jadonk/whitherbone/README.md

# whitherbone

Whithervanes: a neurotic, early worrying system are weathervanes controlled by the climate of fear on the Internet. They were first presented on five buildings in the seaside town of Folkestone, UK as part of the 2014 Folkestone Triennial. The Whithervanes parse newsfeeds looking for predetermined keywords related to fear (e.g. natural disaster, economic collapse, war, etc.) When fear is encountered the chickens respond by rotating away at increasing speeds from fear hot-spots and illuminating different colors triggered by specific levels of fear. Subsequently, 3 more full-size Whithervanes have been commissioned by Locust Projects in Miami for 2018.

We've been asked many times how people can have their own Whithervane. So, we are making the Whithervanes Open Hardware Kit. A prototype version was included in the “Are you talking to me?” exhibition currently in St. Etienne, France. We want to make the Whithervanes Open Hardware Kit a PocketBeagle derivative (Whitherbone), and need some help to do this.

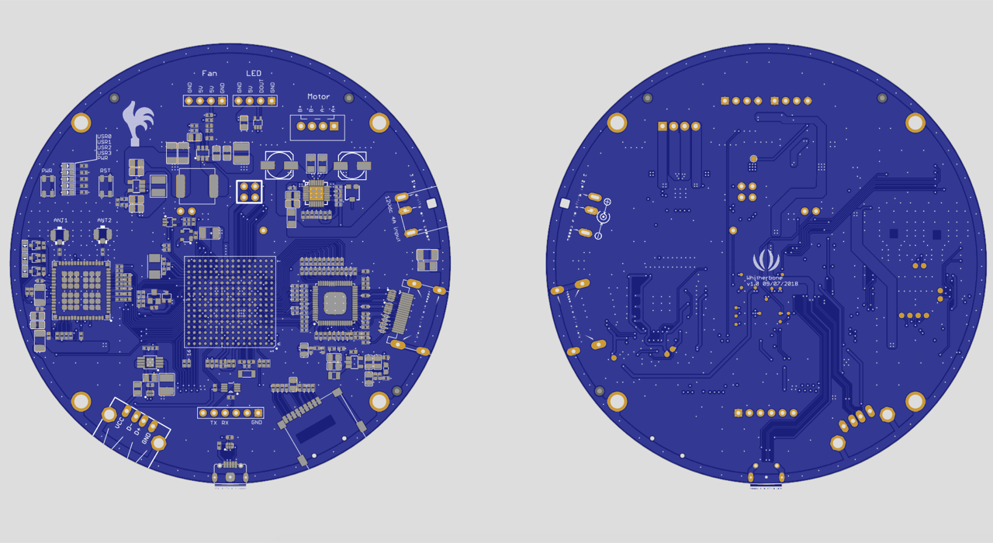
[picture p1: whitherbone.png]
whitherbone rendering Whitherbone


http://www.whithervanes.com/

## Fan
| Pin | Signal |
| --- | --- |
| 1 | GND |
| 2 | +5V |
| 3 | +5V |
| 4 | GND |

## Neopixel ring (LED)

| Pin | Signal | CPU ball | PRU  | SPI | GPIO | 
| --- | --- | --- | ---- | --- | ---- |
| 1 | GND | | | | | 
| 2 | Data (DOUT)  | B2 | 0.2  | 1-MOSI | 112  | 
| 3 | +5V | | | | | 
| 4 | GND | | | | | 

## Motor

### Connector

| Pin | Signal | Wires  |
| --- | --- | --- |
| 1 | Coil 1+ (A+) | Red |
| 2 | Coil 1- (A-) | Green  |
| 3 | Coil 2- (B-) | Blue |
| 4 | Coil 2+ (B+) | Yellow | 

### Control signals

| Ball | GPIO | Signal |
| ---- | ---- | --- |
| T4 | 22 | Step |
| P5 | 23 | Direction |
| R5 | 26 | Reset |
| T5 | 27 | uS1 |
| P6 | 44 | uS2 |
| R6 | 45 | uS3 |
| T6 | 46 | Enable |
| P7 | 47 | Sleep
