jadonk/whitherbone/EAGLE/early-placement.png

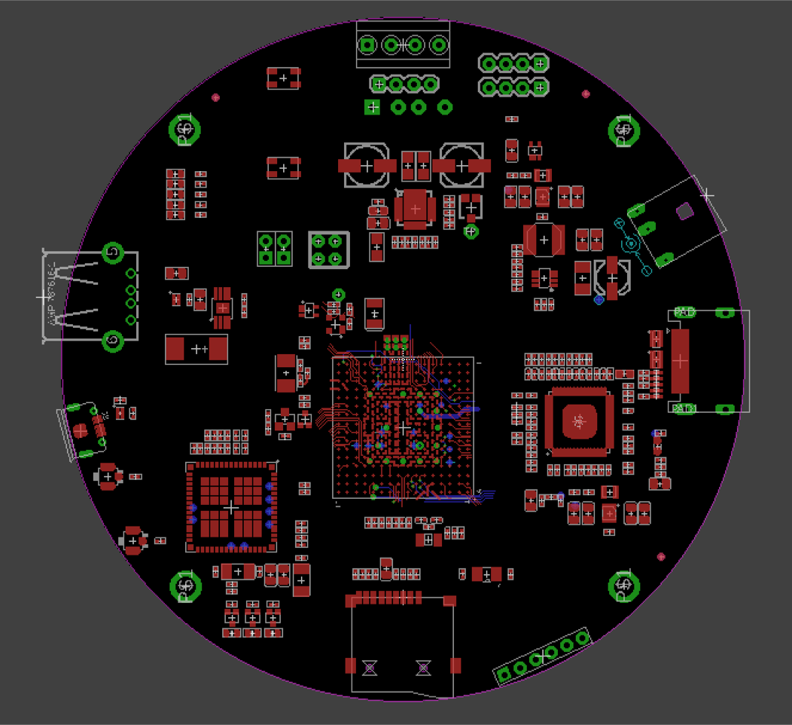
EAGLE/early-placement.png
