jadonk/whitherbone/whitherbone.dxf

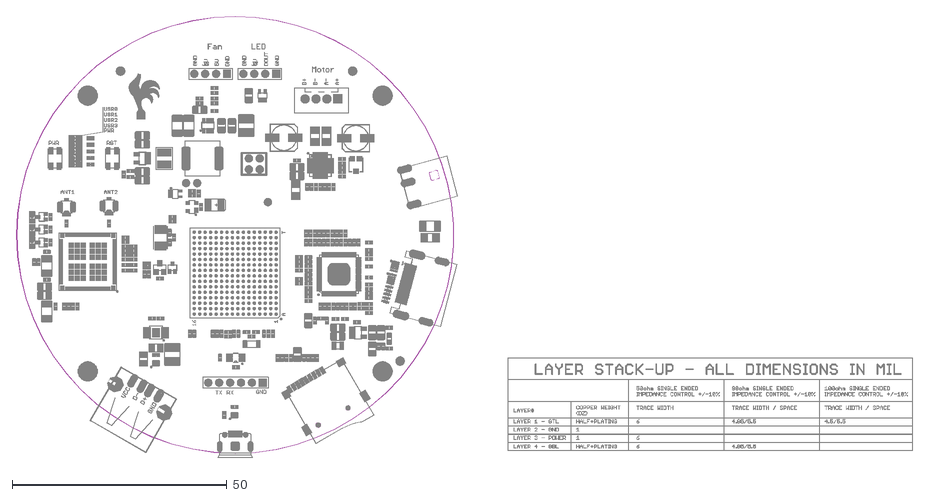
[picture p3: CAD file, 2018-09-12]
whitherbone.dxf
208.4 x 102.7
