jadonk/whitherbone/(threads)

Thread 1 (2017-12-11):

Add TFP410 for HDMI (DVI-D) output

jadonk, 2017-12-11:
TFP410 is desirable due to long product life from TI. Had some issues with the TDAx devices going EOL.

* No audio required, so TFP410 is sufficient. This makes it "DVI-D" to avoid HDMI brand issues, but uses the connector for reduced size and increased cable compatibility.
* Use full-sized HDMI connector.
* Example TFP410 usage at https://github.com/beagleboard/beagleboard-xm/blob/master/BeagleBoard-xM_SCH.pdf, but need to switch to 3.3V signals, not 1.8V.
* BeagleBone HDMI hook-up example at https://github.com/beagleboard/beaglebone-black/blob/master/BBB_SCH.pdf.
* Data lines already connected to avoid potential doubts.
* PocketBeagle use of analog inputs on a couple of the LCD signal lines can be ignored in the case compatibility with expansion boards is desired as an option, but they can also be removed as expansion board compatibility is at most a nice-to-have.

jadonk, 2018-07-16:
I ended up copying the HDMI from BeagleBone Black Wireless, but using the full-sized HDMI connector. I chose a connector I could find easily, though I don't like the tab on it.

Closed 2018-07-16.

Thread 2 (2017-12-11):

Add stepper motor driver and 12V-to-5V based on "Big Easy Driver"

jadonk, 2017-12-11:
Use these links for reference and be sure to provide proper attribution:
* http://www.schmalzhaus.com/BigEasyDriver/index.html
* https://cdn.sparkfun.com/datasheets/Robotics/EasyDriver_v45.pdf

Main devices used:
* LM317: power consumption not a big concern, so keep it simple.
* A3967SLB: lots of other drivers available, but this one is known to work in the application.

I'll probably just grab the KiCAD parts from SnapEDA.

jadonk, 2018-07-17:
EasyDriver and BigEasyDriver aren't the same things. I tried to just cut-and-paste the BigEasyDriver and connect it to GPIOs.

Instead of using an LM317, I added a 7805.

Closed 2018-07-17.

Thread 3 (2017-12-11):

Add WiFi/BT using WL1835MOD based on BeagleBone Blue

jadonk, 2017-12-11:
Need both WiFi and BT. 2.4GHz is sufficient. Simplest just to replicate a known-good interface.

See https://github.com/beagleboard/beaglebone-blue/blob/master/BeagleBone_Blue_sch.pdf for reference.

RobertCNelson, 2017-12-12:
How about the WL1837? So we can get the 5Ghz band??? ;)

RobertCNelson, 2017-12-12:
Bluetooth audio? Remember we need those pull-up's, otherwise remember what happened on teh Green Wireless..

RobertCNelson, 2017-12-12:
n/m it's +$7 / 1ku premium over wl1835modl

jadonk, 2017-12-14:
Yeah, the price is the issue. Maybe it doesn't matter so much and we'll use
that one instead. Probably availability is the biggest deciding factor.
Footprint is compatible.

On Mon, Dec 11, 2017 at 9:54 PM Robert Nelson <notifications@github.com>
wrote:

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
--
https://beagleboard.org/about

jadonk, 2018-07-18:
Which pull-ups?

Got it added based on Black Wireless, then removed the level shifters.

Closed 2018-07-18.

Thread 4 (2017-12-11):

Add 12V power input

jadonk, 2017-12-11:
Use a standard barrel jack.

Feed to LM317 which should provide power to both the stepper motor driver and the "DC" input on the SIP PMIC.

jadonk, 2018-07-17:
Added 7805.

Closed 2018-07-17.

Thread 5 (2017-12-11):

Add fan connector

jadonk, 2017-12-11:
Using this fan: https://www.digikey.com/products/en?keywords=259-1575-nd

Need to determine if a GPIO control is needed or if it is just continuous run. I believe it is just continuous.

jadonk, 2018-07-18:
I just threw on a 4-pin and made outer GND and inner 5V. I also threw on a cap.

Closed 2018-07-18.

Thread 6 (2017-12-11):

Add connector for Neopixel ring

jadonk, 2017-12-11:
Here's the Neopixel ring: https://www.adafruit.com/product/1586

Needs 5V, GND and signal.

Signal thoughts:
* Use a PRU-capable-GPIO for the signal
* Assuming sk6812 controller
* Some consideration of the LEDscape library: https://libraries.io/github/Yona-Appletree/LEDscape
* A SPI-MOSI connection might also be of some benefit if programming was done that way, instead of using PRUs
* I'm thinking BSM ball B2 (ZCZ ball D12) which is SPI1_D1 (mode 3), PRU0_OUT2 (mode 5) and GPIO3_16

Needs some input on planned programming model

jadonk, 2018-07-18:
Stuck a 4 pin connector on there for now. Added on a 74AHCT125 for level shifting, but it is a bit of overkill (4 output).

Closed 2018-07-18.

Thread 10 (2018-07-19):

Review from Erik Welsh

jadonk, 2018-07-19:
1) Connect VIN_BAT to PMIC_BAT_SENSE, per recommendation in TPS65217 datasheet rev I figure 56.

2) From BBBW, add one or two cap footprints on both the input and output of the flip flop (IC13) to allow for easy addition of filtering caps when testing for FCC/CE.  Alternatively, you could you could add an external 12MHz oscillator (ASDMB-12.000MHZ-LC-T) and use the same clock disable.

3) On the BigEasy Driver, the VDD needs to be 3.3V and not 5V so that the IO voltage is 3.3V.

4) The datasheet for the A4983 recommends bulk capacitors on the VBB.  Currently there is a 47uF on the 12V input.  Depending on where that is placed, it might be enough, but you should check once you have more placement done to see if you need to put an additional bulk cap on VBB.

5) Would suggest using something like the Tag Connect footprint for the JTAG connector.

6) Not sure if you want to add all the testpoints for the WL1835 (see BB Blue)

7) Depending on the layout, you can flip the D+ / D- inputs of IC14 and IC15.  Within the TPD4S012, D+ and D- are the same circuit.

8) You might want to look at a different package (i.e. the DQA vs the DGS) for IP4283CZ10 (TPD4S009DGSR).

9) You might want to look at the SOT-223 package for the 7805T  depending on cost vs board area needs.

Thread 11 (2018-08-02):

Organize the hardware design requirements

qunanan, 2018-08-02:
**Schematic**

1. 12V power input. Since the 7805 is low efficiency, let's use DCDC modulator insted.
2. Based on OSD3358-SM-RED with eagle project.
3. WiFi&Bluetooth enableing with WL1835 module
4. TFP410 for HDMI output, full size HDMI connector
5. Stepper motor controller based on "Big Easy Driver"
6. Screw terminal connector for Motor, it is stable and in common use
7. Voltagle level shiffting for Neopixel ring. Make a 4pin connector for it.Pay atention with the control pin.
8. A continuous running fan is needed.
9. Status LEDs should be included.
10. Reset and power buttons should be included.
11. There should be a serial header.

**PCB Layout**

1. Make board circular at standard thickness(1.6mm)
2. Diameter must be less than 4" and is desired to be as small as possible
3. Edge connectors should be placed on edges with any particular restriction except to simplify layout
4. Try to stick to a 4 layer board for easy OSHPark production

qunanan, 2018-08-02:
Maybe we can use IT66121FN for HDMI interface.It's much lower cost.
See HDMI cape for BBG: [https://www.seeedstudio.com/SeeedStudio-BeagleBone-Green-HDMI-Cape-p-2570.html](url)

Thread 12 (2018-09-13):

Layout Review Feedback

erikwelsh, 2018-09-13:
Found a couple of things while reviewing the layout:

1) The PWR_IN_12V doesn't look connected to power connector very well.  There is plenty of room on the top to make that connection better

2) There is some weird keepout around the PWR_IN_12V via on the Route15 layer which is causing connection issues.  It looks like the footprint for that connector is not correct

3) The SYS_VDD1_3P3V pour on the Route15 layer is not straight on the right side

4) There is a weird little stub pour on the Route15 layer for N$14

5) Are the two antennas far enough apart?  I wasn't sure the min distance for MIMO.

qunanan, 2018-09-14:
Hi,
1. The layout file is not the latest. It has been Fixed.
2. This is a known issue caused by the earlier version of Eagle, it's not good support for the slot pad. The gerber file is correct.
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
3. Sorry, I don't really understand what do you mean, can you explain more detailedly
4. Fixed
5.No, but I think we could the put the antennas far apart since there is wire between the antennas an d connectors.

Thread 13 (2018-09-13):

Schematic printing issue

erikwelsh, 2018-09-13:
There is some text on the "guide" layer (98) which is causing printing issues.  You can either move or delete the text.

Closed 2018-11-13.

Thread 14 (2018-11-13):

Need to create device tree

jadonk, 2018-11-13:
Seeed did most of this hack. I just added the WIFI LED.

This needs to be cleaned up.

```
From 6b8c1664318fc4ec7c0b2a9de9507e0a6be16978 Mon Sep 17 00:00:00 2001
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
