jadonk/whitherbone/EAGLE/whitherbone_sch.pdf

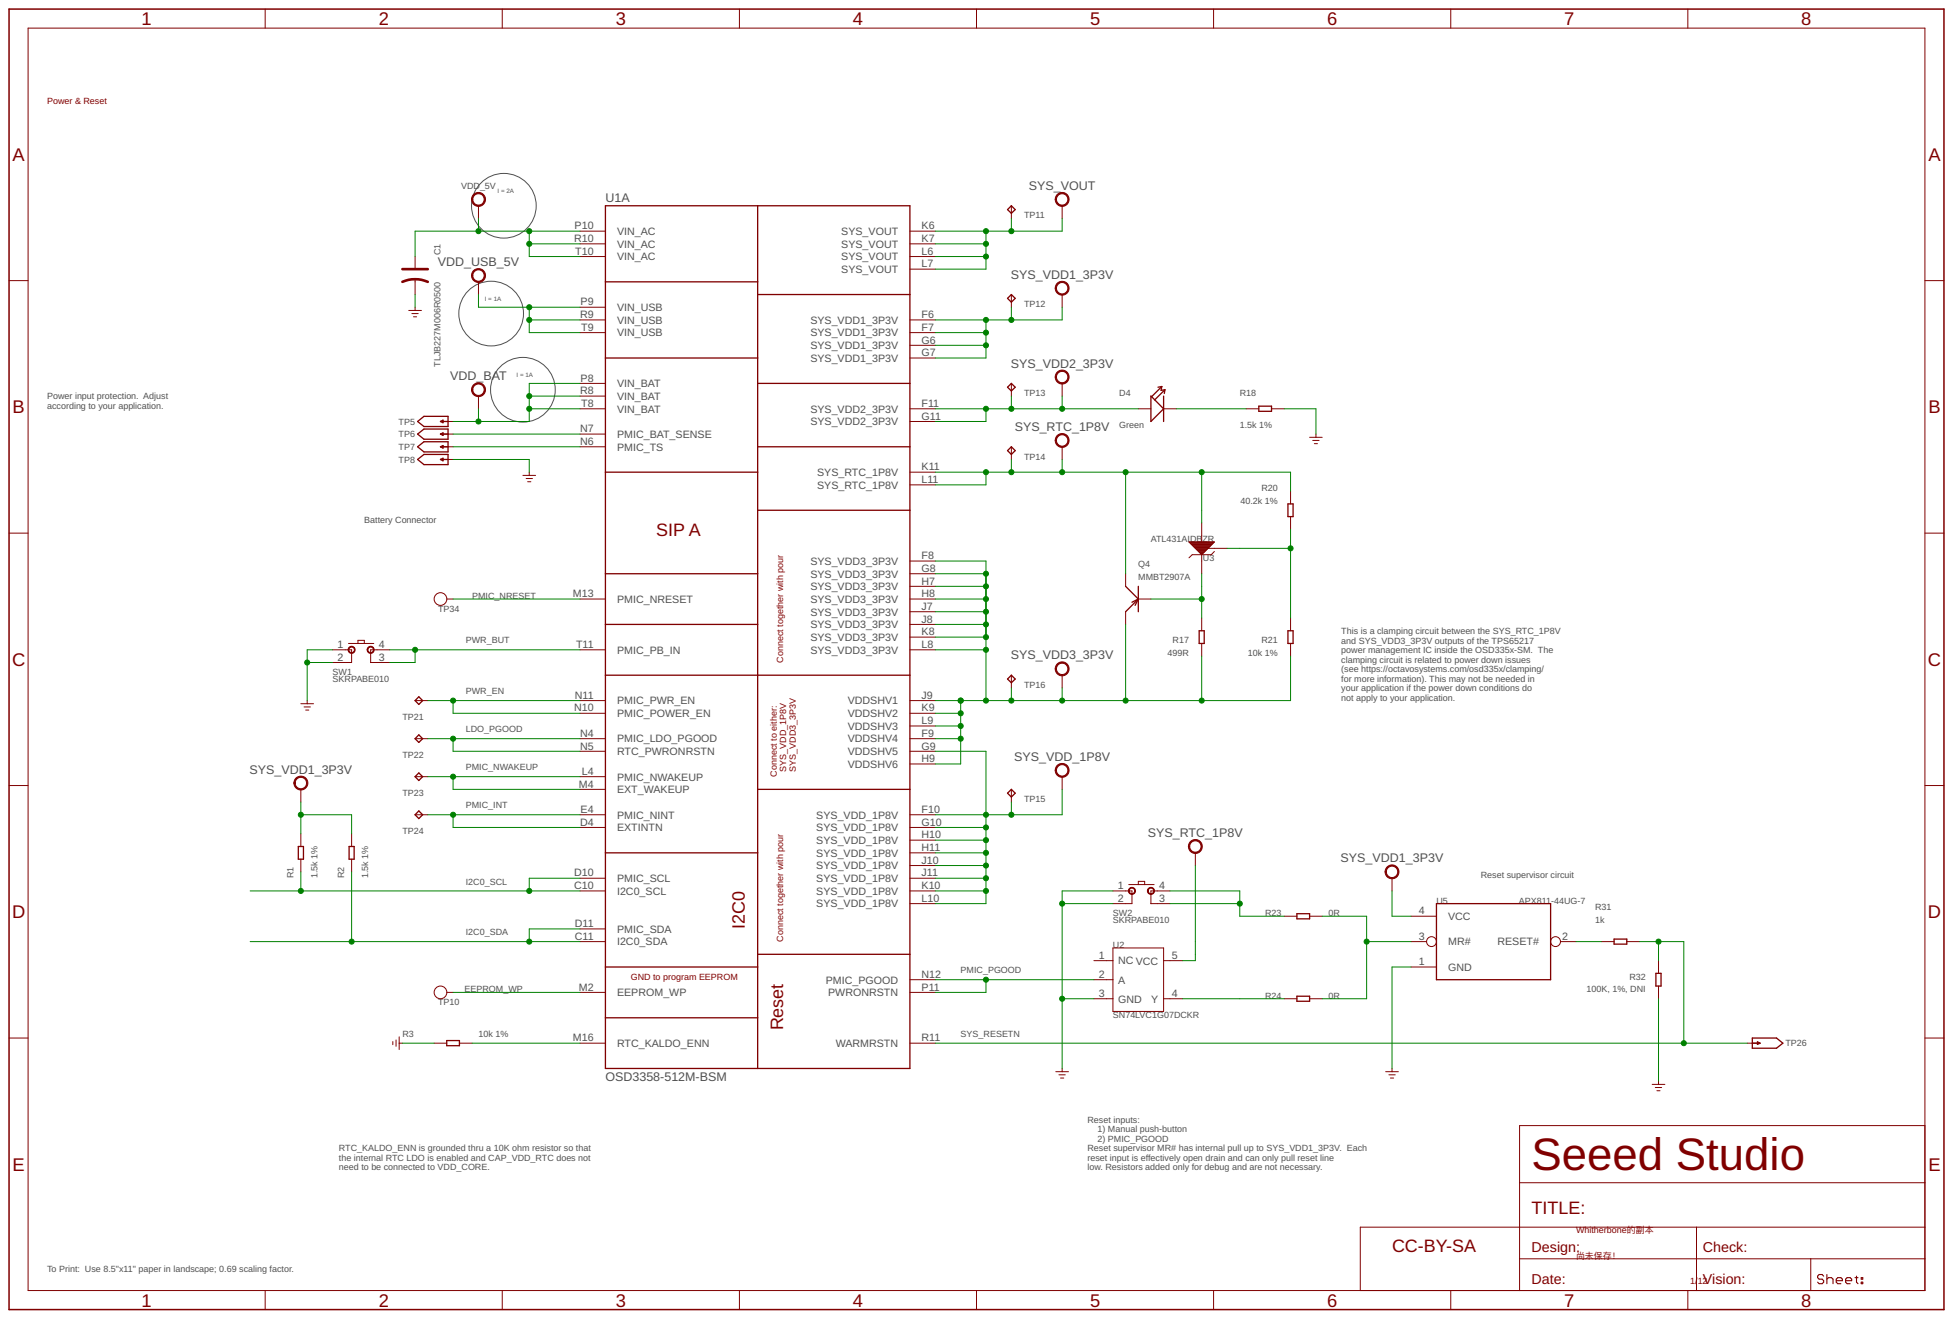
[picture p4: page 1]

Power input protection. Adjust according to your application.

SYS_VDD3_3P3V Connect together with pour Connect together with pour

This is a clamping circuit between the SYS_RTC_1P8V
and SYS_VDD3_3P3V outputs of the TPS65217
power management IC inside the OSD335x-SM. The
clamping circuit is related to power down issues
(see https://octavosystems.com/osd335x/clamping/
for more information). This may not be needed in
your application if the power down conditions do
not apply to your application.

et Connect to either: SYS_VDD_1P8V

GND to program EEPROM

Reset inputs: 1) Manual push-button
2) PMIC_PGOOD
Reset supervisor MR# has internal pull up to SYS_VDD1_3P3V. Each
reset input is effectively open drain and can only pull reset line
low. Resistors added only for debug and are not necessary.

RTC_KALDO_ENN is grounded thru a 10K ohm resistor so that
the internal RTC LDO is enabled and CAP_VDD_RTC does not need to be connected to VDD_CORE.

CC-BY-SA | Whitherbone的副本 Design: 尚未保存！ | Check:

To Print: Use 8.5"x11" paper in landscape; 0.69 scaling factor.

Date: | Vision:

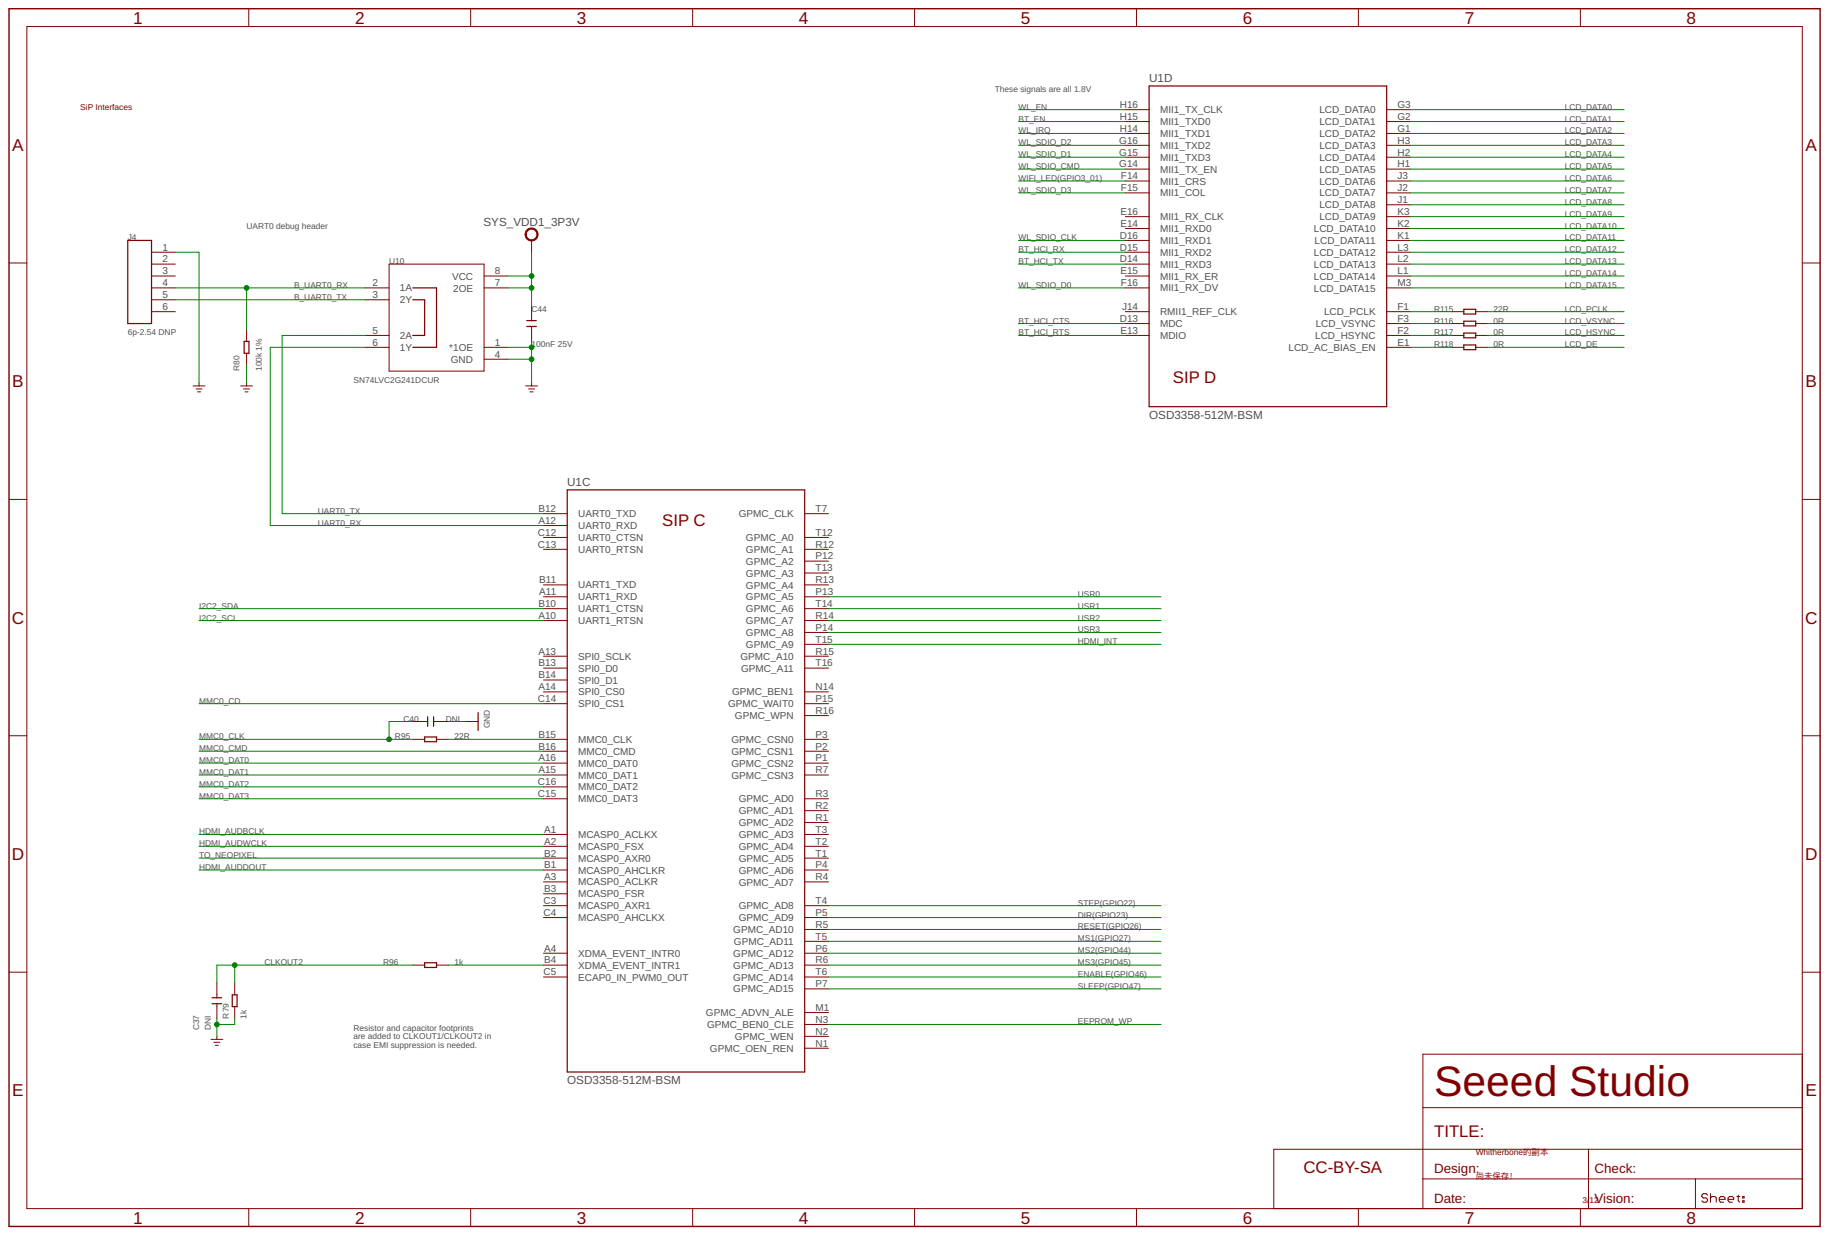
[picture p5: page 2]

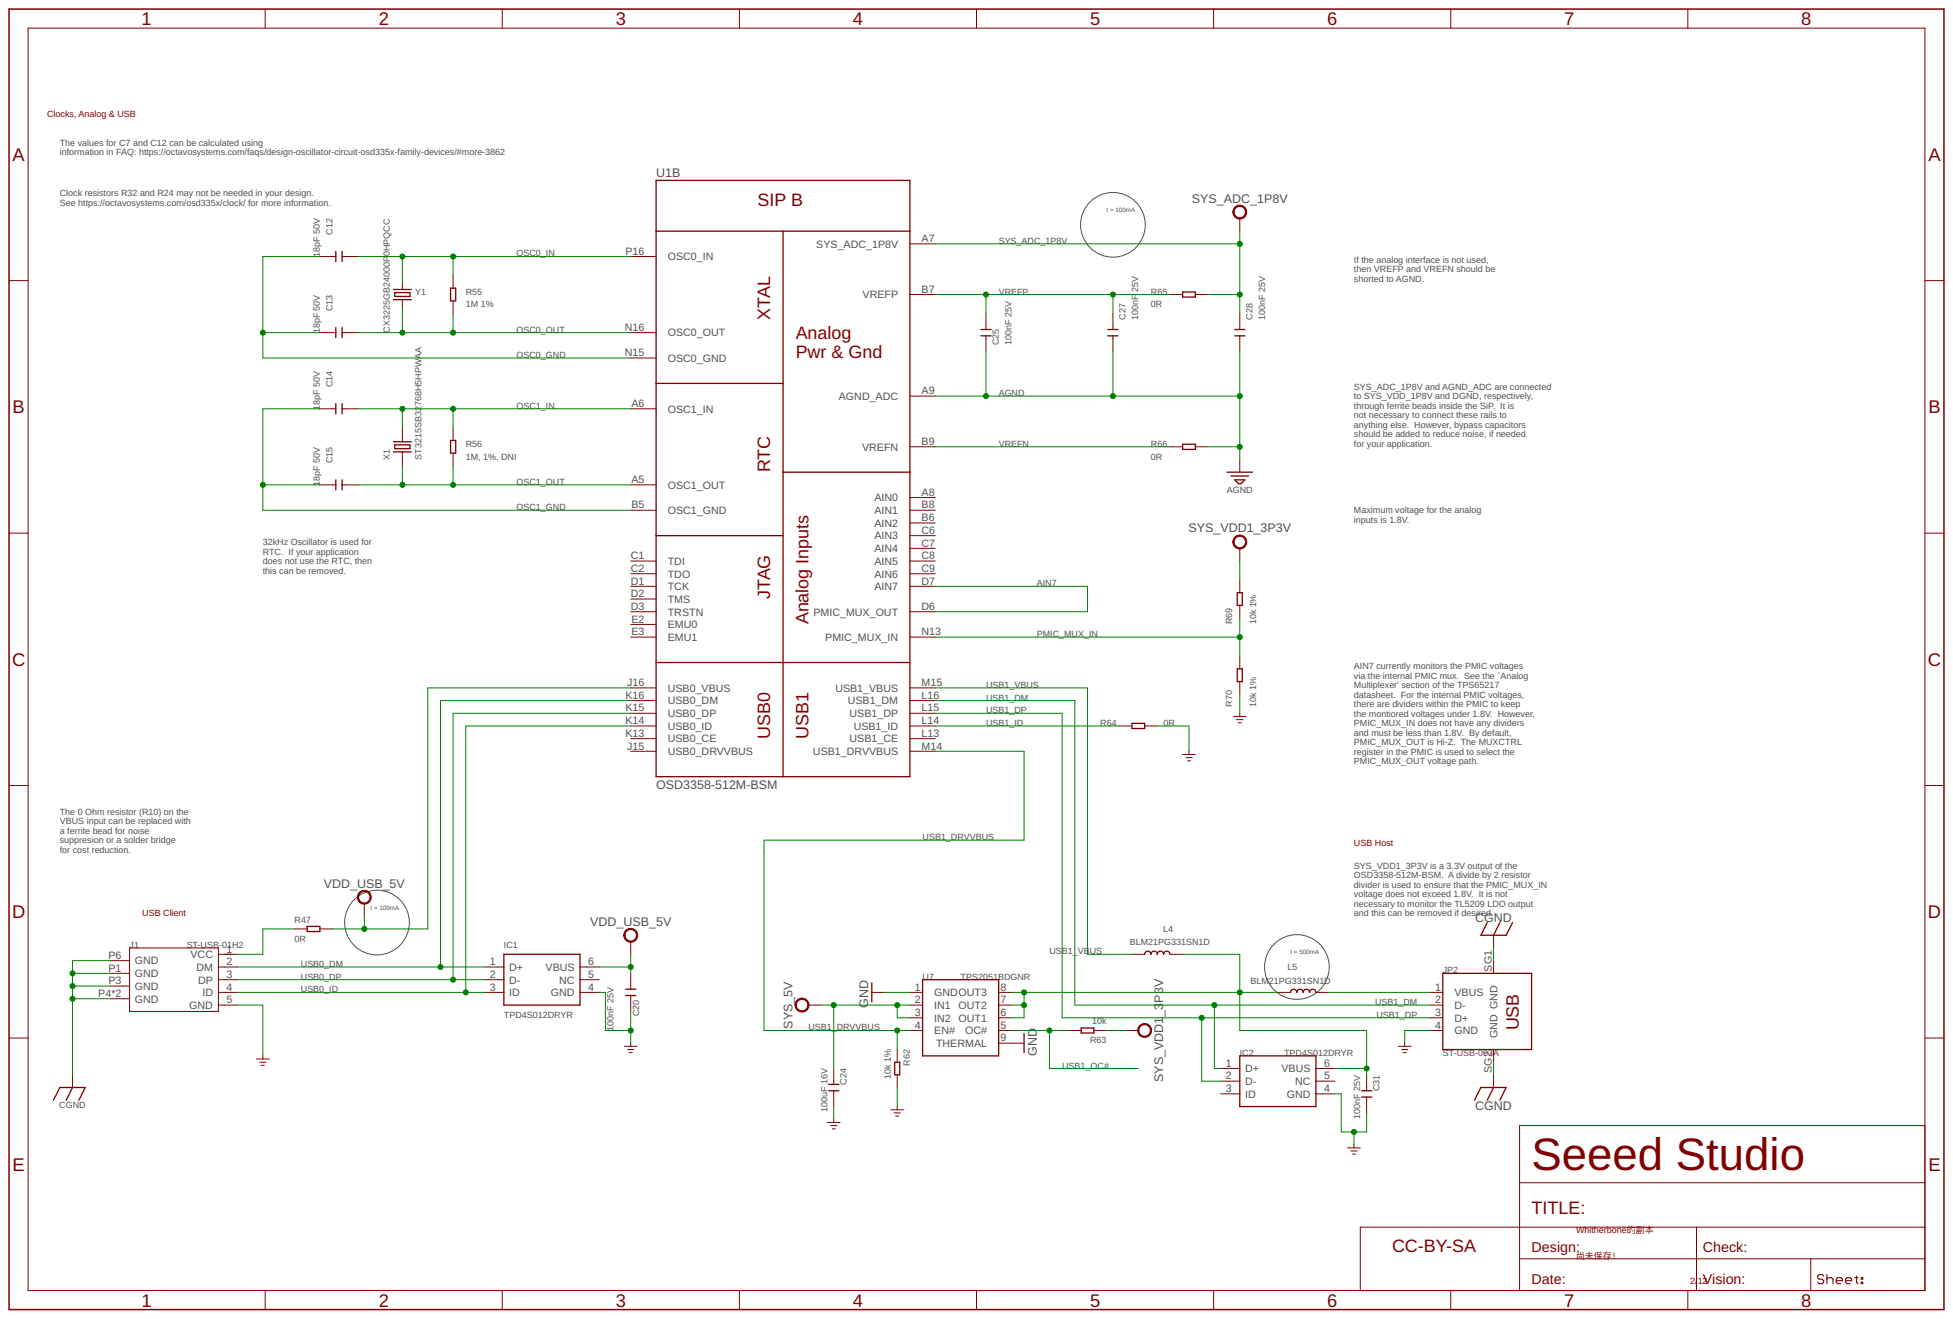
[picture p6: page 3]

The values for C7 and C12 can be calculated using
information in FAQ: https://octavosystems.com/faqs/design-oscillator-circuit-osd335x-family-devices/#more-3862

Clock resistors R32 and R24 may not be needed in your design. See https://octavosystems.com/osd335x/clock/ for more information.

OSC0_IN OSC0_OUT N16 OSC0_GND | SYS_ADC_1P8V VREFP Analog Pwr & Gnd AGND_ADC

If the analog interface is not used,
then VREFP and VREFN should be
shorted to AGND.

SYS_ADC_1P8V and AGND_ADC are connected
to SYS_VDD_1P8V and DGND, respectively,
through ferrite beads inside the SiP. It is not necessary to connect these rails to
anything else. However, bypass capacitors
should be added to reduce noise, if needed
for your application.

Maximum voltage for the analog
inputs is 1.8V.

32kHz Oscillator is used for RTC. If your application
does not use the RTC, then
this can be removed.

AIN7 currently monitors the PMIC voltages
via the internal PMIC mux. See the `Analog Multiplexer' section of the TPS65217
datasheet. For the internal PMIC voltages,
there are dividers within the PMIC to keep
the montiored voltages under 1.8V. However, PMIC_MUX_IN does not have any dividers and must be less than 1.8V. By default, PMIC_MUX_OUT is Hi-Z. The MUXCTRL

register in the PMIC is used to select the PMIC_MUX_OUT voltage path.

The 0 Ohm resistor (R10) on the VBUS input can be replaced with
a ferrite bead for noise
suppresion or a solder bridge
for cost reduction.

SYS_VDD1_3P3V is a 3.3V output of the OSD3358-512M-BSM. A divide by 2 resistor divider is used to ensure that the PMIC_MUX_IN

voltage does not exceed 1.8V. It is not necessary to monitor the TL5209 LDO output and this can be removed if desired.

3 USB1_DP

CC-BY-SA | Whitherbone的副本 Design: 尚未保存！ | Check:

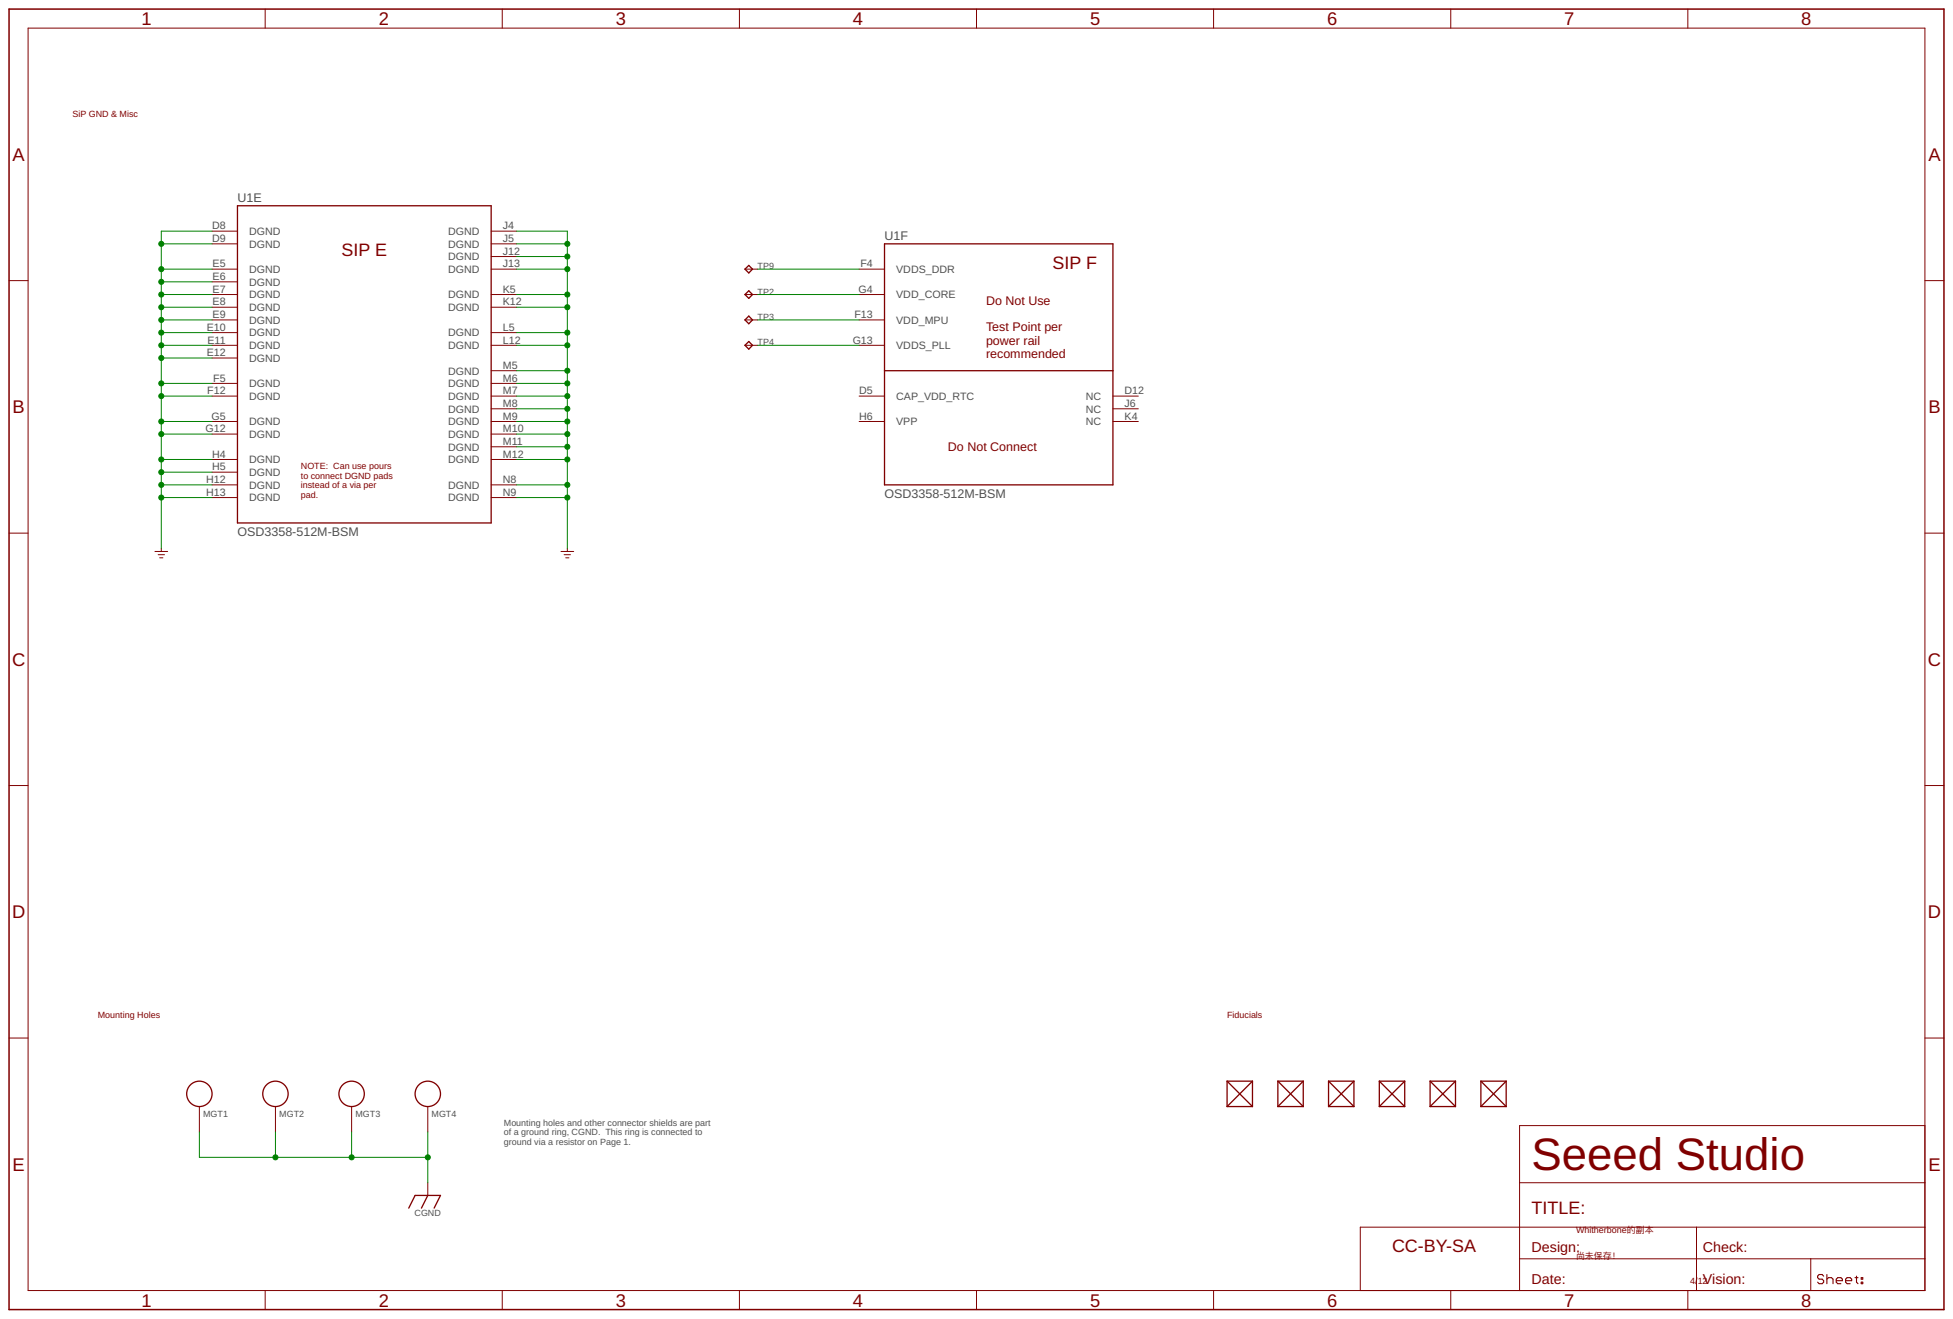
[picture p7: page 4]

Do Not Use Test Point per power rail recommended

NOTE: Can use pours
to connect DGND pads
instead of a via per pad.

Mounting holes and other connector shields are part of a ground ring, CGND. This ring is connected to
ground via a resistor on Page 1.

CC-BY-SA | Whitherbone的副本 Design: 尚未保存！ | Check:

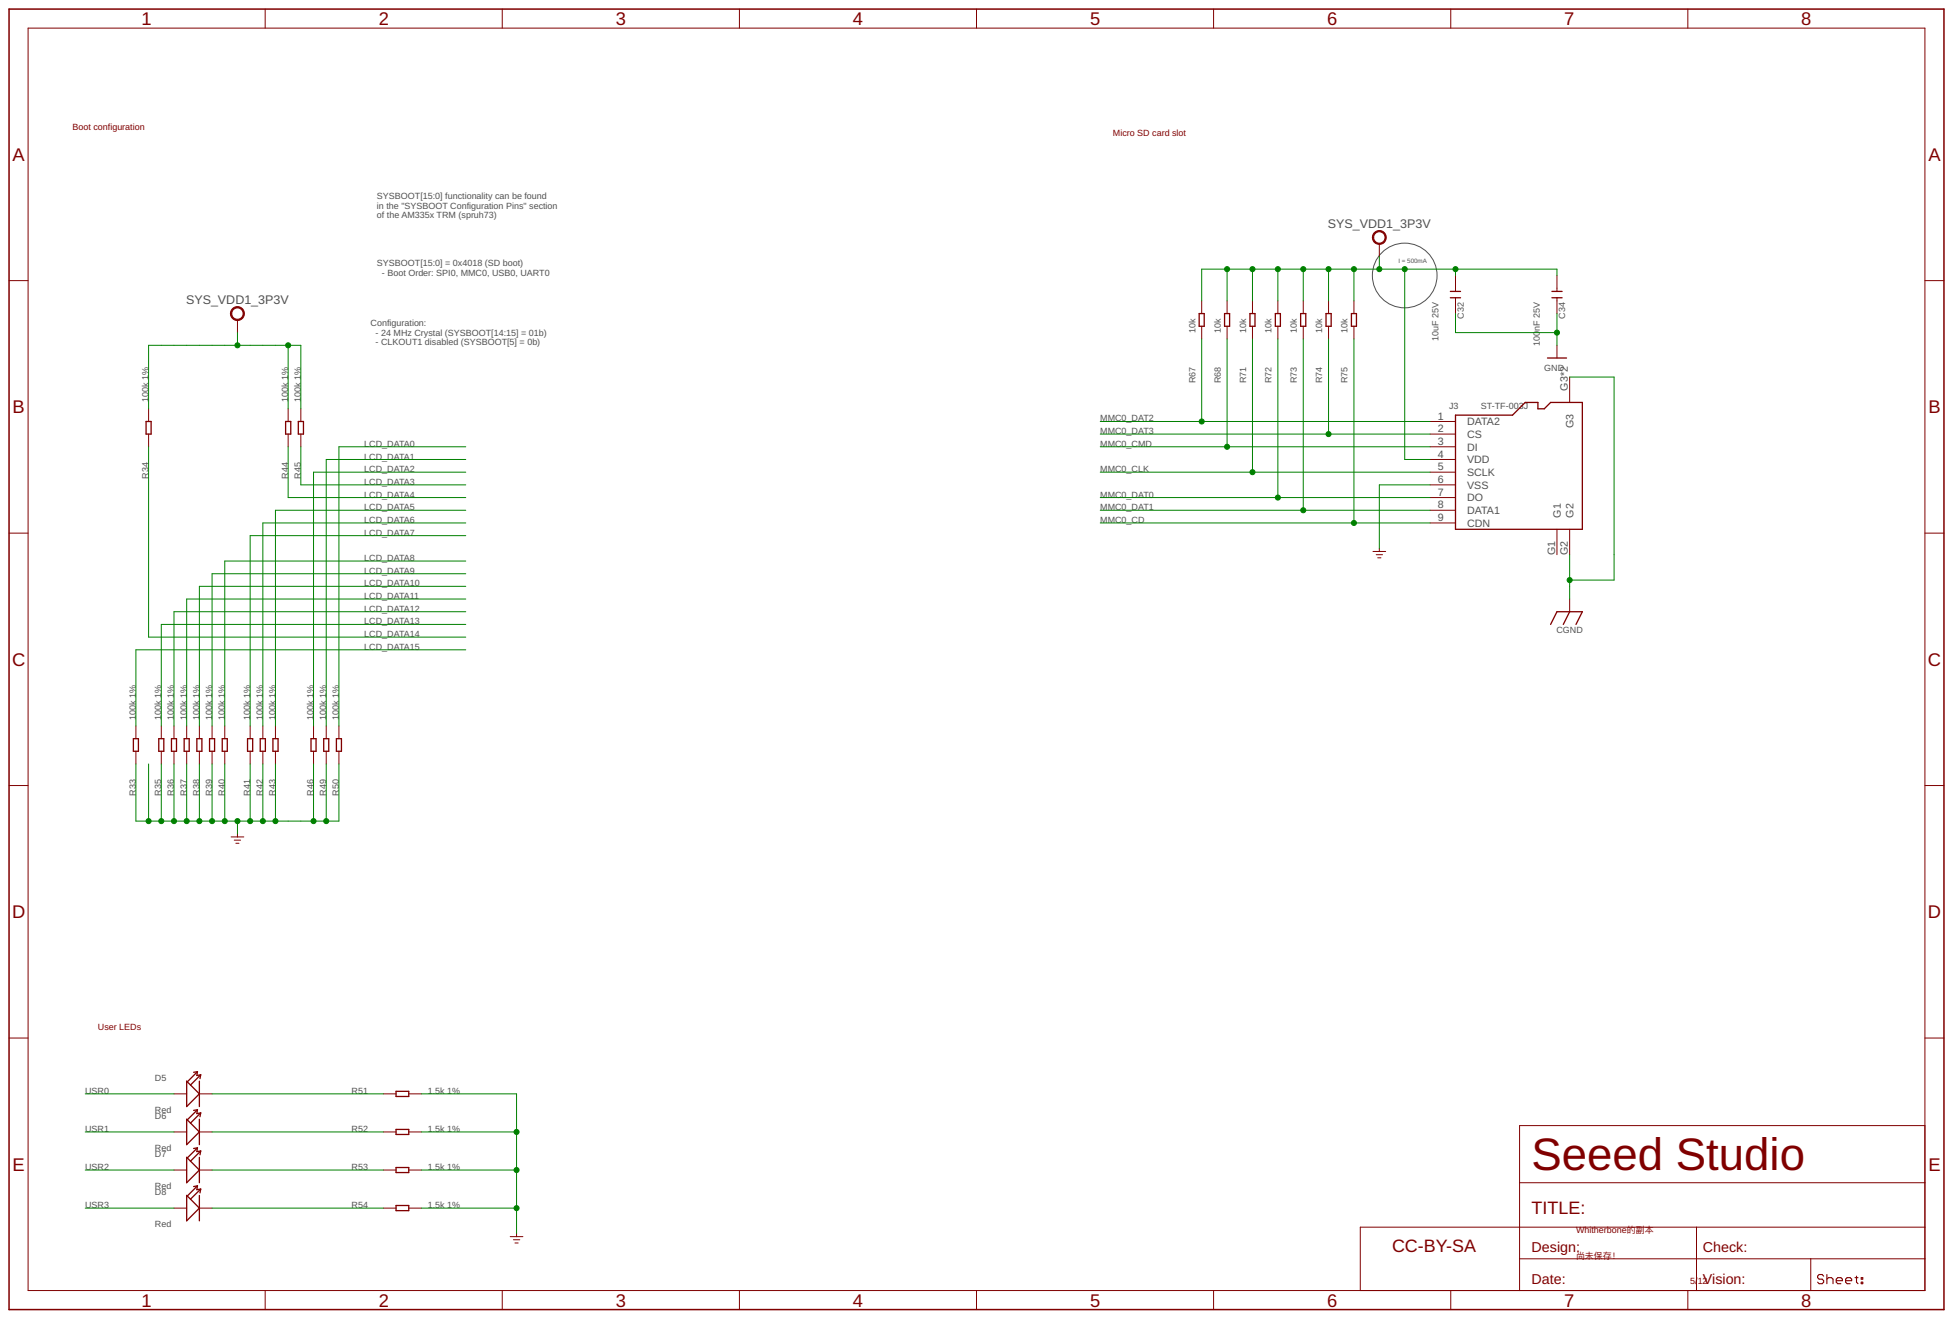
[picture p8: page 5]

SYSBOOT[15:0] functionality can be found
in the "SYSBOOT Configuration Pins" section
of the AM335x TRM (spruh73)

Configuration: - 24 MHz Crystal (SYSBOOT[14:15] = 01b)
- CLKOUT1 disabled (SYSBOOT[5] = 0b)

Red Red

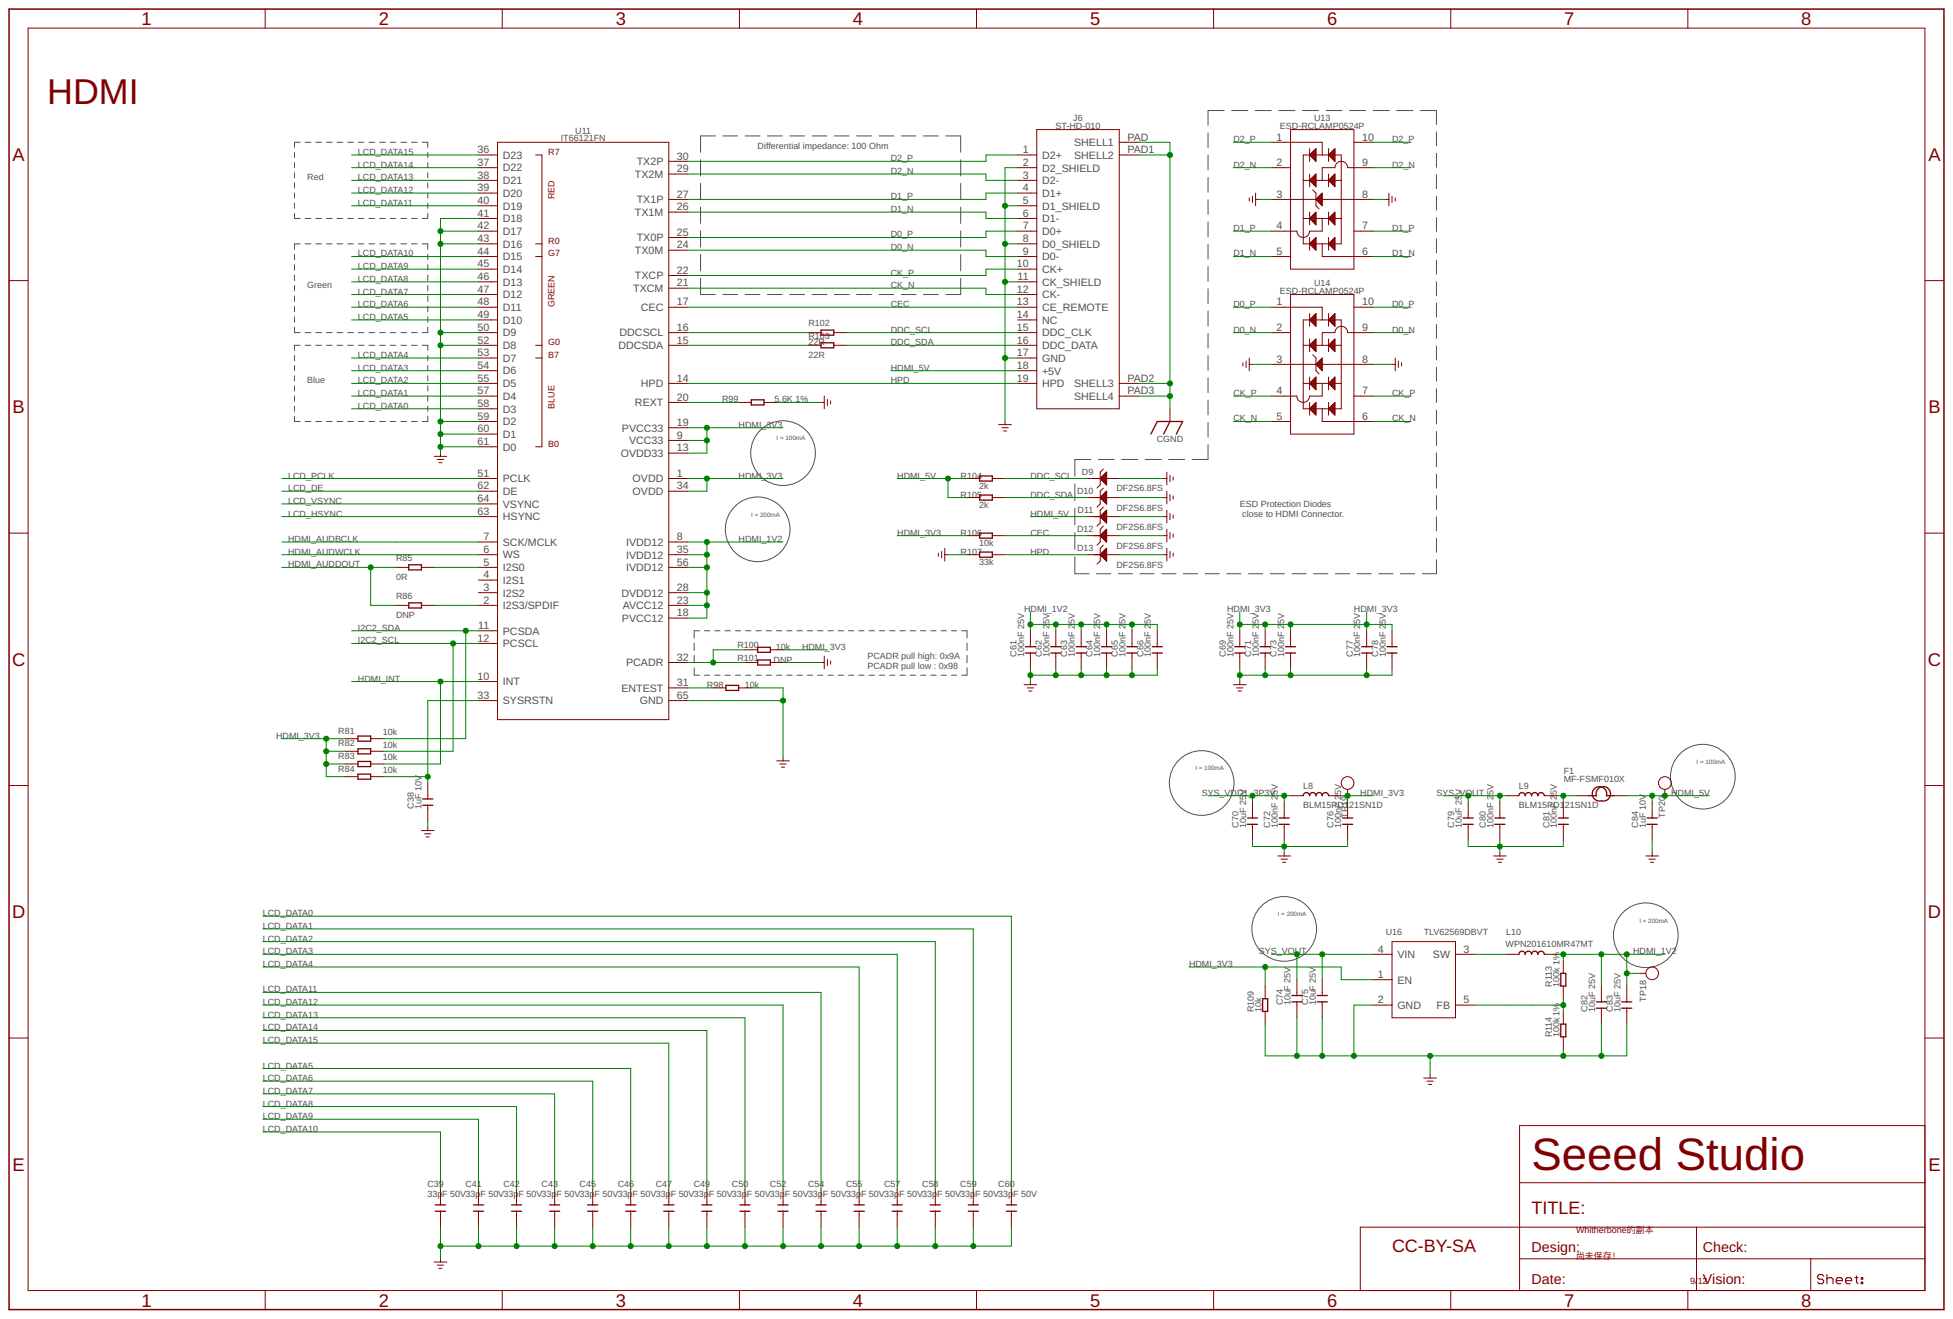
[picture p9: page 6]

ESD Protection Diodes
close to HDMI Connector.

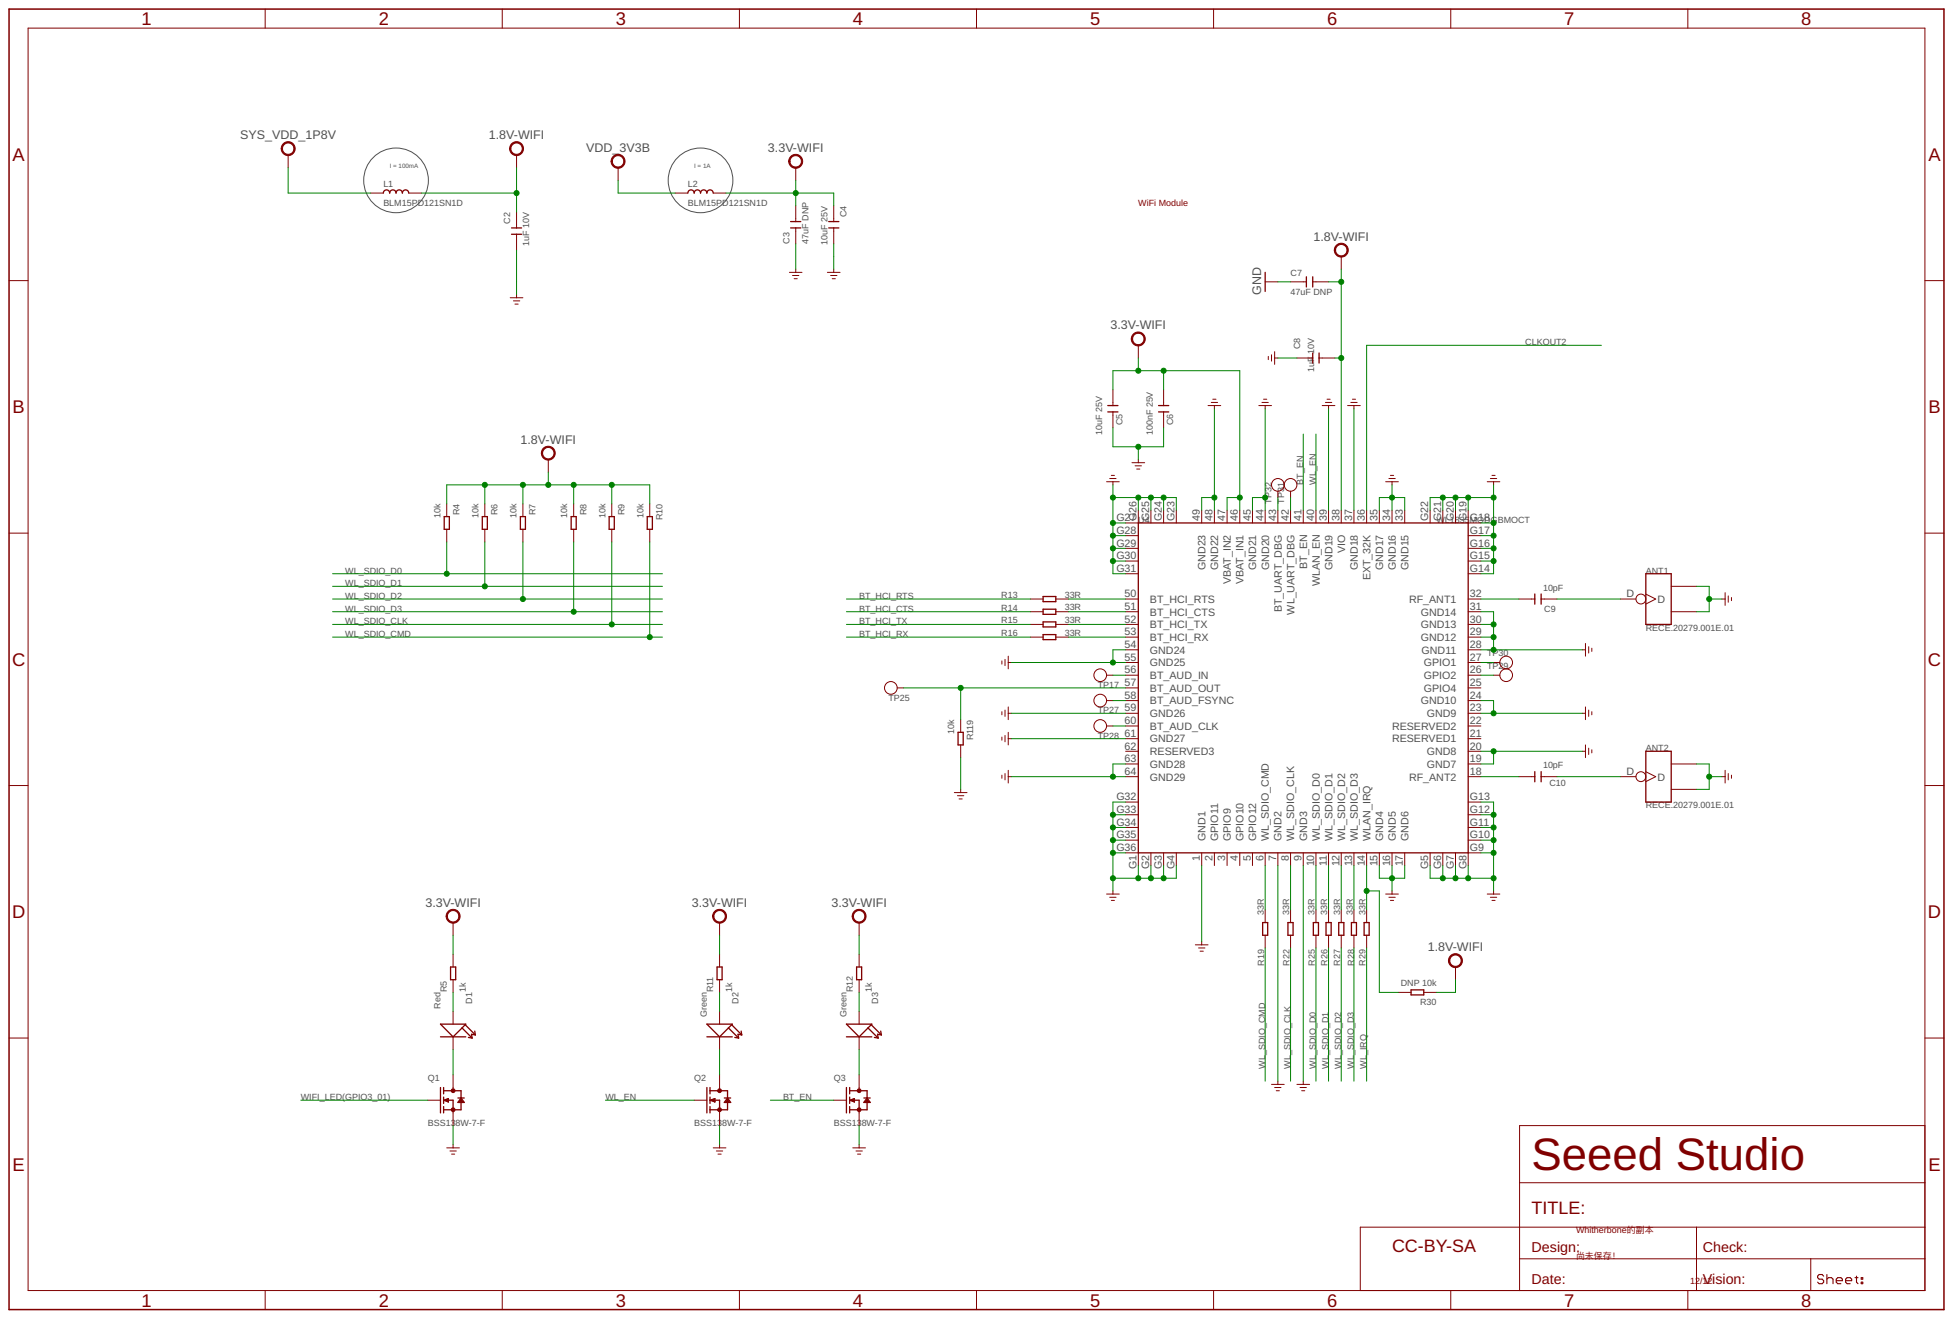
[picture p10: page 7]

CC-BY-SA | Whitherbone的副本 Design: 尚未保存！ | Check:

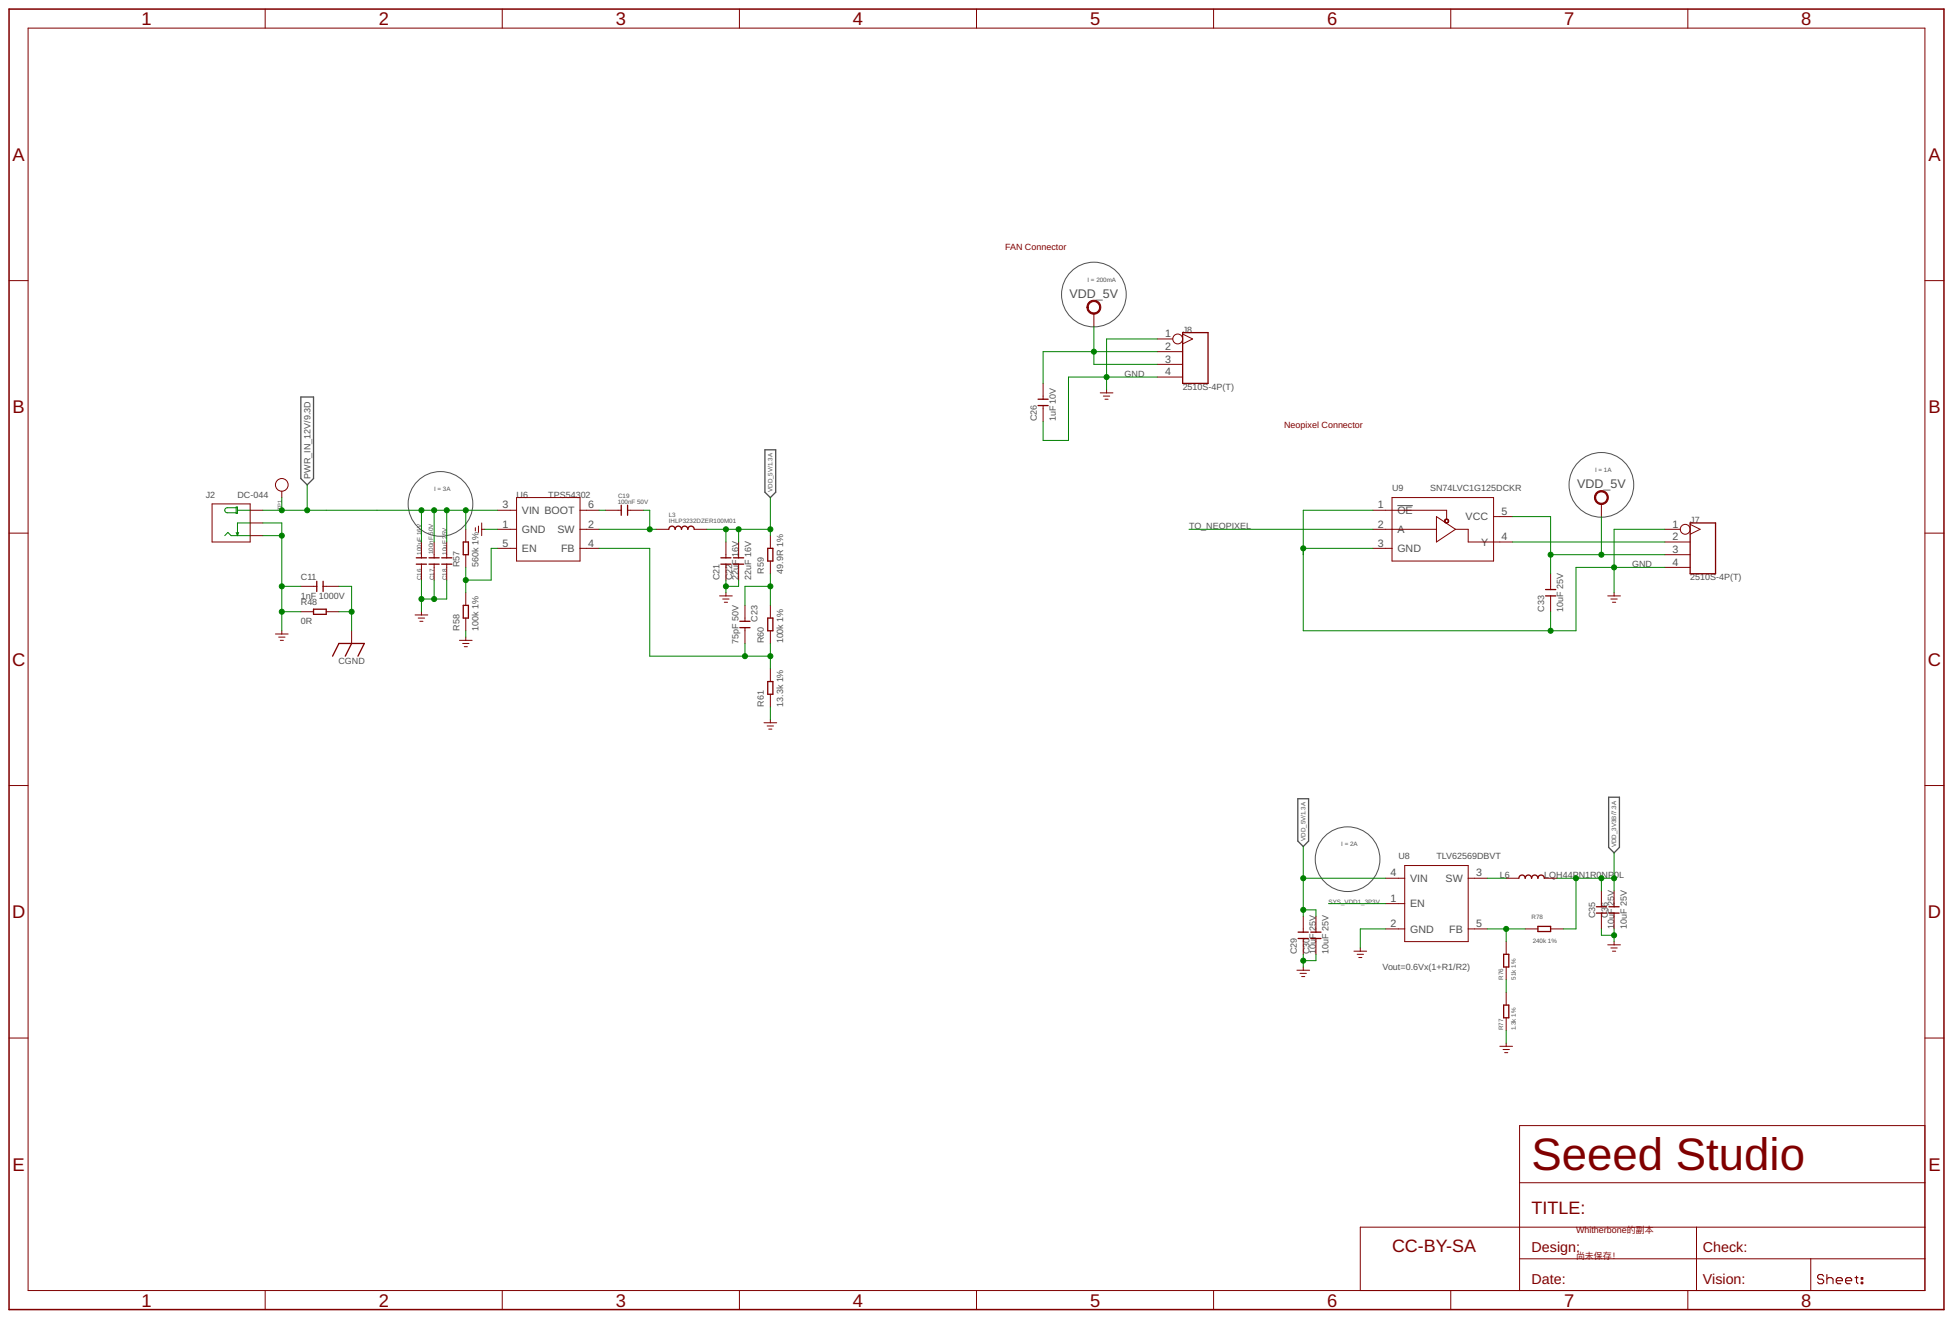
[picture p11: page 8]

4 GND

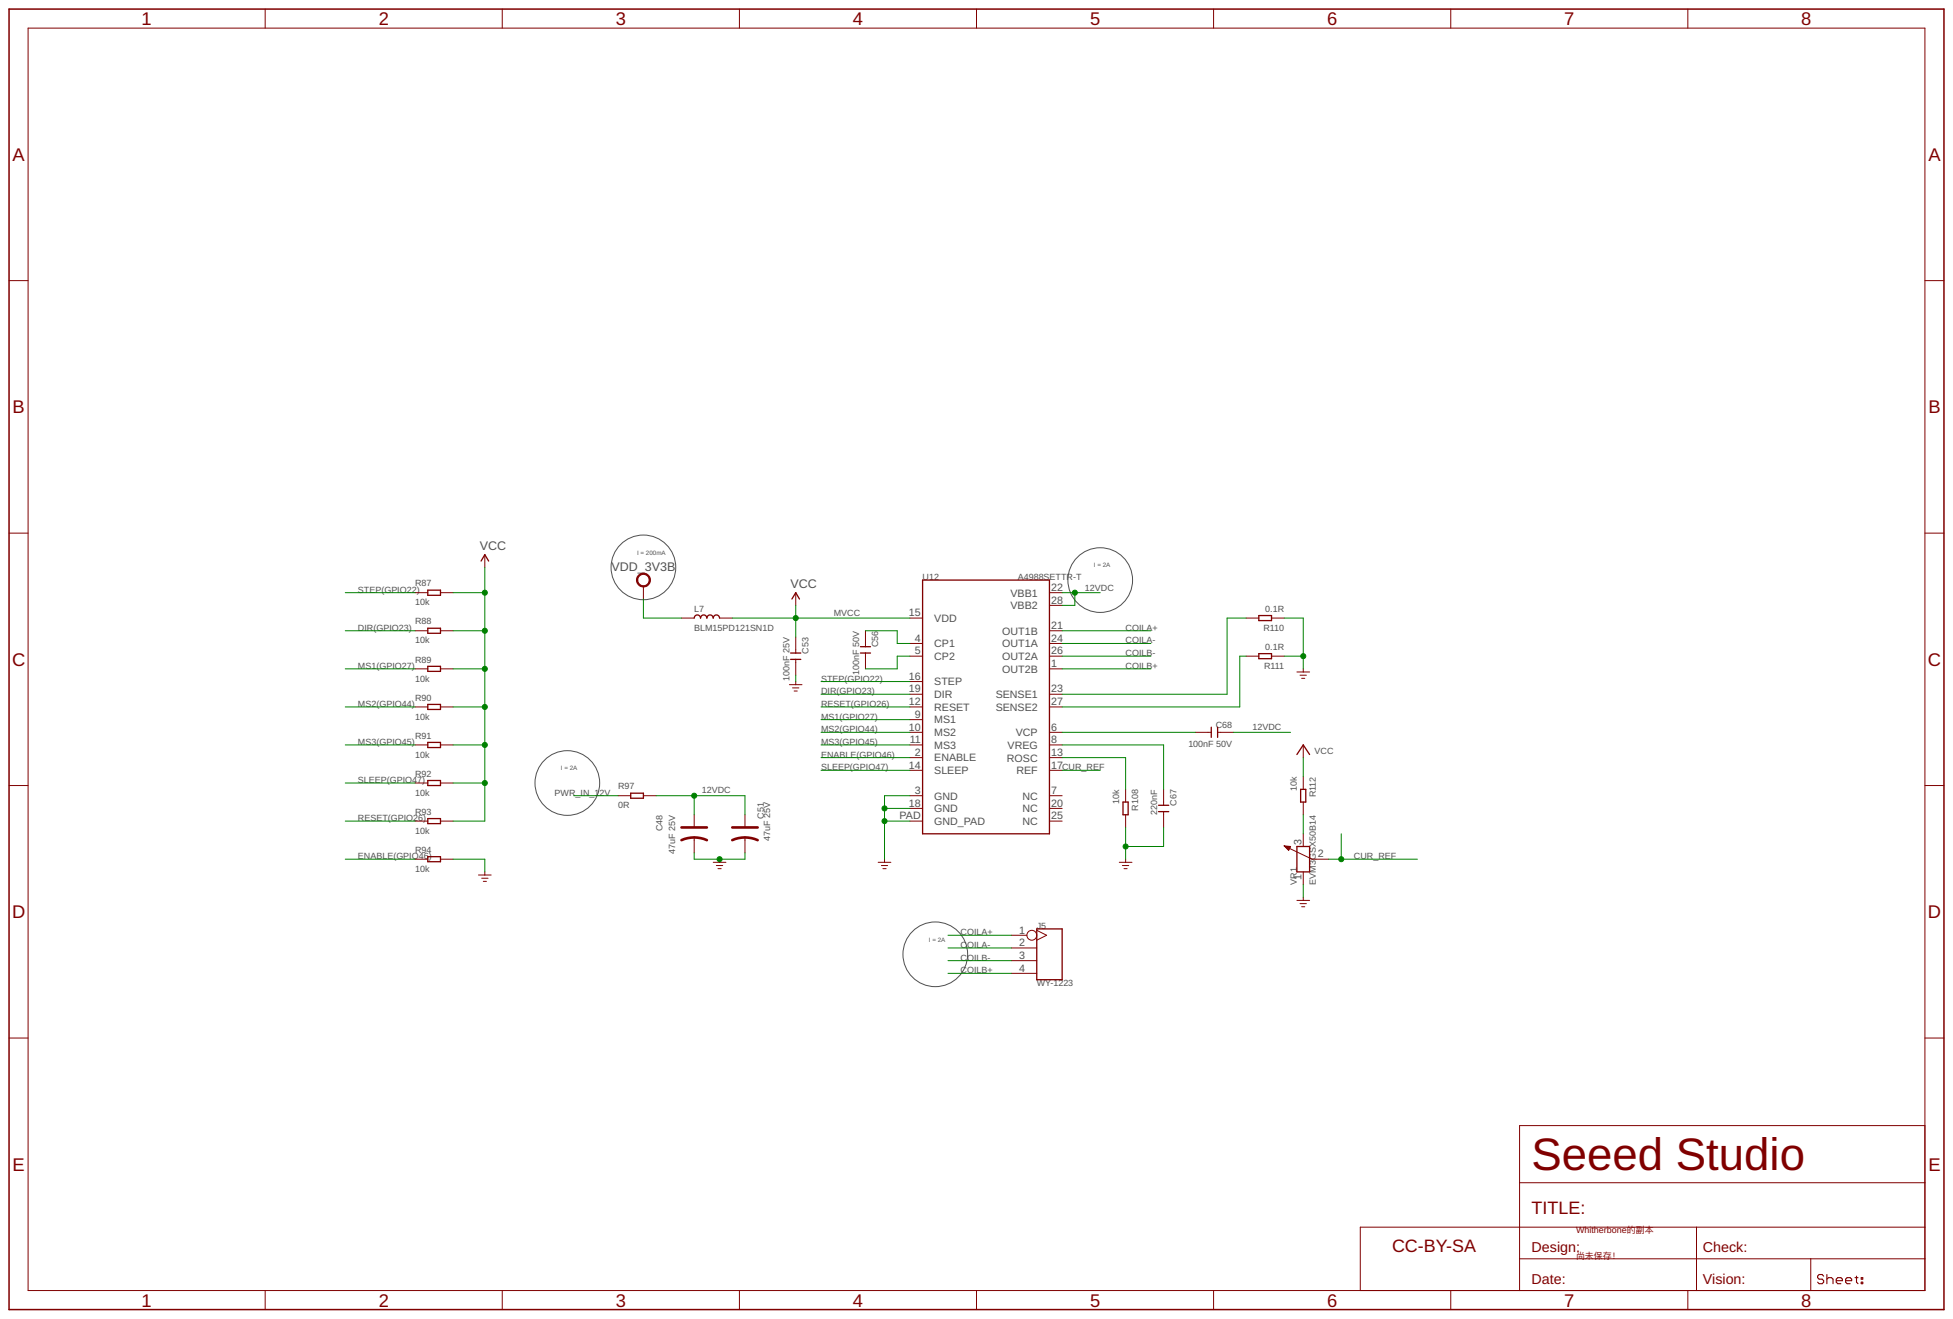
[picture p12: page 9]
