jadonk/whitherbone/KiCAD/witherbone.kicad_pcb

## KiCad design KiCAD/witherbone.kicad_pcb (2017-12-11)

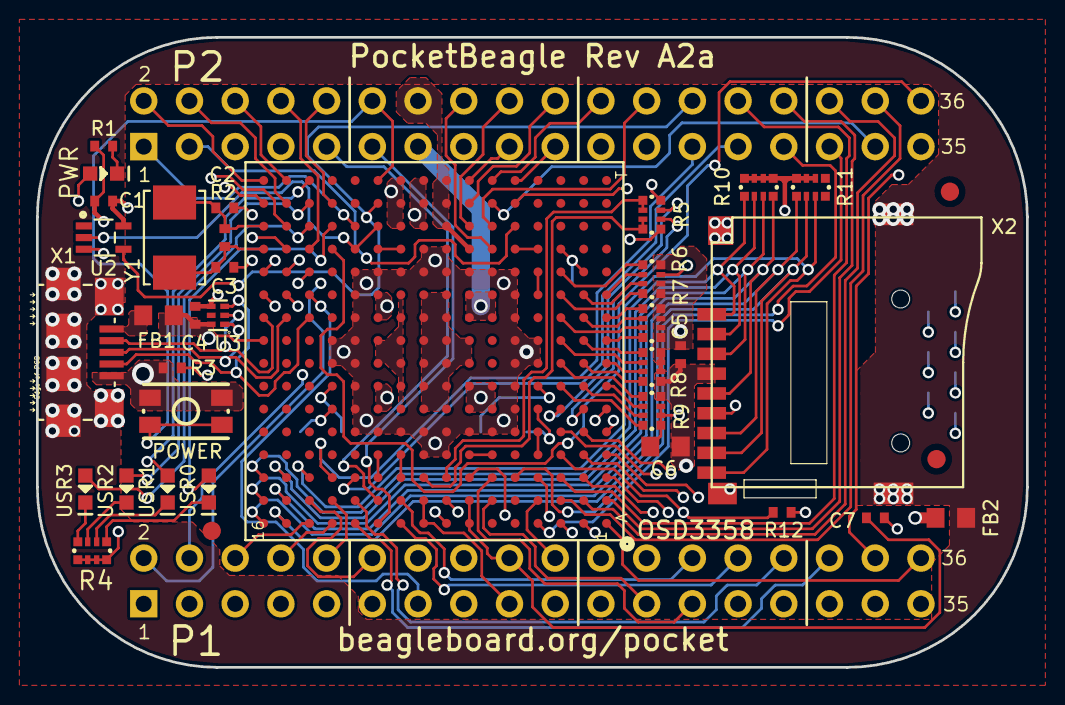
[picture p13: board witherbone.kicad_pcb from above]

Board: 4 copper layers, 55.0 x 35.0 mm, 50 parts (0 on the bottom side), 133 nets.

Parts:
C1, C5, C7: 0.1uF, 6.3V; 0402
C2, C3: 18pF, 50V; 0402
C4: .1uF, 6.3V; 0402
C6: 10uF, 10V; 0603
FB1, FB2: 0603
FUD1, FUD2, FUD3: FIDUCIAL; FIDUCIAL_40MIL
LED1: PWR; 0603-LED
P1, P2: TH-2X18-(35MIL-DIA)-W_O-SILK
R1: 1k; 0402
R2: 1M, 1%; 0402
R3, R12: 10k; 0402
R4: 1k; RN0804
R5, R10, R11: 10k; RN0804
R6, R7, R8, R9: 100k; RN0804
SW1: POWER; MINI_PUSHBUTTON
TP1: VDDS_DDR; B1_27
TP2: VDD_CORE; B1_27
TP3: VDD_MPU; B1_27
TP4: VDDS_PLL; B1_27
TP5: TMS; B1_27
TP6: TDI; B1_27
TP7: TDO; B1_27
TP8: TCK; B1_27
TP9: EMU0; B1_27
TP10: TRST; B1_27
TP11: EMU1; B1_27
TP12: WP; B1_27
U1: OSD3358-512M-BSM; OSD335X-BGA-256
U2: SN74LVC1G07DCK; SC70(TI-DCK)
U3: TPD4S012DRY; SON-6(TI)-DRY
USR0, USR1, USR2, USR3: LTST-C191TBKT; 0603-LED
X1: 10118192-0001LF; 10118192-0001LF(MICRO-USB-B-AMPHENOL-FCI)
X2: MICROSD
Y1: 24 MHz; CRYSTAL_5X3.2MM

Connections:
/(U1.A1)PWM0A: P1.36, U1.A1
/(U1.A2)PRU-0.1: P1.33, U1.A2
/(U1.A3)PRU-0.4: P1.31, U1.A3
/(U1.A4)SPI1.CS: P2.31, U1.A4
/(U1.A8)AIN0~1.8V: P1.19, U1.A8
/(U1.A10)I2C2.SCL: P1.28, U1.A10
/(U1.A11)I2C1.SDA: P2.11, U1.A11
/(U1.A12)UART0.RX: P1.32, U1.A12
/(U1.A13)SPI0.CLK: P1.8, U1.A13
/(U1.A14)SPI0.CS: P1.6, U1.A14
/(U1.A15)MMC0.D1: R11.6, U1.A15, X2.8
/(U1.A16)MMC0.D0: R11.5, U1.A16, X2.7
/(U1.B1)PRU-0.3: P2.30, U1.B1
/(U1.B2)PRU-0.2: P2.32, U1.B2
/(U1.B3)PRU-0.5: P2.34, U1.B3
/(U1.B4)PRU-0.16: P1.20, U1.B4
/(U1.B6)AIN2~1.8V: P1.23, U1.B6
/(U1.B7)VREF+: C7.1, P1.18, U1.A7, U1.B7
/(U1.B8)AIN1~1.8V: P1.21, U1.B8
/(U1.B9)VREF-: C7.2, P1.17, U1.A9, U1.B9
/(U1.B10)I2C2.SDA: P1.26, U1.B10
/(U1.B11)I2C1.SCL: P2.9, U1.B11
/(U1.B12)UART0.TX: P1.30, U1.B12
/(U1.B13)SPI0.MISO: P1.10, U1.B13
/(U1.B14)SPI0.MOSI: P1.12, U1.B14
/(U1.B15)MMC0.CLK: R10.4, U1.B15, X2.5
/(U1.B16)MMC0.CMD: R10.3, U1.B16, X2.3
/(U1.C3)PRU-0.6: P2.28, U1.C3
/(U1.C4)PRU-0.7: P1.29, U1.C4
/(U1.C5)SPI1.CLK: P2.29, U1.C5
/(U1.C6)AIN3~1.8V: P1.25, U1.C6
/(U1.C7)AIN4~1.8V: P1.27, U1.C7
/(U1.C8)AIN5~1.8V: R5.1, R5.2, U1.C8
/(U1.C9)AIN6~1.8V: R5.3, R5.4, U1.C9
/(U1.C12)SPI1.MISO: P2.27, U1.C12
/(U1.C13)SPI1.MOSI: P2.25, U1.C13
/(U1.C14)MMC0.CD: R11.7, U1.C14, X2.9
/(U1.C15)MMC0.D3: R10.2, U1.C15, X2.2
/(U1.C16)MMC0.D2: R10.1, U1.C16, X2.1
/(U1.E1): P1.4, U1.E1
/(U1.F1): P1.35, U1.F1
/(U1.F2)AIN6~3.3V: P1.2, R5.6, U1.F2
/(U1.F3)AIN5~3.3V: P2.35, R5.7, U1.F3
/(U1.G1)LCD.D2.B5: R9.6, U1.G1
/(U1.G2)LCD.D1.B4: R9.7, U1.G2
/(U1.G3)LCD.D0.B3: R9.8, U1.G3
/(U1.H1)LCD.D5.G2: R8.3, U1.H1
/(U1.H2)LCD.D4.B7: R8.4, U1.H2
/(U1.H3)LCD.D3.B6: R9.5, U1.H3
/(U1.J1)LCD.D8.G5: R7.4, U1.J1
/(U1.J2)LCD.D7.G4: R8.1, U1.J2
/(U1.J3)LCD.D6.G3: R8.2, U1.J3
/(U1.K1)LCD.D11.R3: R7.1, U1.K1
/(U1.K2)LCD.D10.G7: R7.2, U1.K2
/(U1.K3)LCD.D9.G6: R7.3, U1.K3
/(U1.K14)USBC.ID: U1.K14, U3.3, X1.ID
/(U1.K15)USBC.D+: U1.K15, U3.1, X1.D+
/(U1.K16)USBC.D-: U1.K16, U3.2, X1.D-
/(U1.L1)LCD.D14.R6: R6.2, U1.L1
/(U1.L2)LCD.D13.R5: R6.3, U1.L2
/(U1.L3)LCD.D12.R4: R6.4, U1.L3
/(U1.L14)USB1.ID: P1.13, U1.L14
/(U1.L15)USB1.D+: P1.11, U1.L15
/(U1.L16)USB1.D-: P1.9, U1.L16
/(U1.M2)EEPROM.WP: TP12.TP, U1.M2, U1.N3
/(U1.M3)LCD.D15.R7: R6.1, U1.M3
/(U1.M14)USB1.DRVVBUS: P1.3, U1.M14
/(U1.M15)USB1.VBUS: P1.5, U1.M15
/(U1.N13)AIN7~1.8V: P2.36, U1.N13
/(U1.N14): P2.8, U1.N14
/(U1.P5)GPIO-0.23: P2.3, U1.P5
/(U1.P6): P2.24, U1.P6
/(U1.P7)PRU-0.15: P2.18, U1.P7
/(U1.P12)PWM1A: P2.1, U1.P12
/(U1.P13)USR0: U1.P13, USR0.A
/(U1.P14)USR3: U1.P14, USR3.A
/(U1.P15)UART4.RX: P2.5, U1.P15
/(U1.R5)GPIO-0.26: P1.34, U1.R5
/(U1.R6): P2.33, U1.R6
/(U1.R7): P2.20, U1.R7
/(U1.R11)RESET#: P2.26, U1.R11, U2.4
/(U1.R13): P2.10, U1.R13
/(U1.R14)USR2: U1.R14, USR2.A
/(U1.R15): P2.4, U1.R15
/(U1.R16)UART4.TX: P2.7, U1.R16
/(U1.T5): P2.19, U1.T5
/(U1.T6)PRU-0.14: P2.22, U1.T6
/(U1.T7): P2.17, U1.T7
/(U1.T11)PWR.BTN: P2.12, SW1.3, SW1.4, U1.T11
/(U1.T14)USR1: U1.T14, USR1.A
/(U1.T15): P2.6, U1.T15
/(U1.T16): P2.2, U1.T16
/BAT.TEMP: P2.16, U1.N6
/JTAG_EMU0: TP9.TP, U1.E2
/JTAG_EMU1: TP11.TP, U1.E3
/JTAG_TCK: TP8.TP, U1.D1
/JTAG_TDI: TP6.TP, U1.C1
/JTAG_TDO: TP7.TP, U1.C2
/JTAG_TMS: TP5.TP, U1.D2
/JTAG_TRST#: R12.2, TP10.TP, U1.D3
/N$1: R4.3, USR2.K
/N$2: R4.4, USR3.K
/N$4: LED1.K, R1.2
/N$5: R4.2, USR1.K
/N$6: R4.1, USR0.K
/N$7: TP1.TP, U1.F4
/N$9: TP2.TP, U1.G4
/N$10: TP3.TP, U1.F13
/N$11: TP4.TP, U1.G13
/N$12: U1.D6, U1.D7
/N$22: R3.2, U1.M16
/N$24: U1.N4, U1.N5
/N$25: U1.L4, U1.M4
/N$26: U1.D4, U1.E4
/N$27: U1.N10, U1.N11
/N$31: U1.C11, U1.D11
/N$32: U1.C10, U1.D10
/OSC.GND: C2.1, C3.1, U1.N15
/OSC.IN: C2.2, R2.2, U1.P16, Y1.2
/OSC.OUT: C3.2, R2.1, U1.N16, Y1.1
/PMIC_PGOOD: U1.N12, U1.P11, U2.2
CGND: FB2.1, X1.CGND, X2.G1, X2.G2, X2.G3, X2.G4
GND: C1.2, C4.2, C5.2, C6.2, FB2.2, P1.15, P1.16, P1.22, P2.15, P2.21, R1.1, R3.1, R4.5, R4.6, R4.7, R4.8, R5.5, R5.8, R6.5, R6.6, R6.8, R7.5, R7.6, R7.7, R7.8, R8.6, R8.7, R8.8, R9.1, R9.2, R9.3, R12.1, SW1.1, SW1.2, U1.D8, U1.D9, U1.E5, U1.E6, U1.E7, U1.E8, U1.E9, U1.E10, U1.E11, U1.E12, U1.F5, U1.F12, U1.G5, U1.G12, U1.H4, U1.H5, U1.H12, U1.H13, U1.J4, U1.J5, U1.J12, U1.J13, U1.K5, U1.K12, U1.L5, U1.L12, U1.M5, U1.M6, U1.M7, U1.M8, U1.M9, U1.M10, U1.M11, U1.M12, U1.N8, U1.N9, U2.3, U3.4, X1.GND, X2.6
SYS_5V: P1.24, P2.13, U1.K6, U1.K7, U1.L6, U1.L7
USB_DC: C4.1, FB1.2, P1.7, U1.J16, U1.P9, U1.R9, U1.T9, U3.6
VBUS.RAW: FB1.1, X1.VBUS
VDD_1V8: U1.F10, U1.G10, U1.H10, U1.H11, U1.J10, U1.J11, U1.K10, U1.L10
VDD_3V3A: U1.F8, U1.F9, U1.G8, U1.G9, U1.H7, U1.H8, U1.H9, U1.J7, U1.J8, U1.J9, U1.K8, U1.K9, U1.L8, U1.L9
VDD_3V3AUX: LED1.A, U1.F11, U1.G11
VDD_3V3B: C5.1, C6.1, P1.14, P2.23, R6.7, R8.5, R9.4, R10.5, R10.6, R10.7, R10.8, R11.2, R11.3, R11.4, U1.F6, U1.F7, U1.G6, U1.G7, X2.4
VDD_5V: P1.1, U1.P10, U1.R10, U1.T10
VDD_RTC: C1.1, U1.K11, U1.L11, U2.5
VIN.BAT: P2.14, U1.N7, U1.P8, U1.R8, U1.T8
