jadonk/whitherbone/EAGLE/whitherbone.brd

## EAGLE design EAGLE/whitherbone.brd (2018-11-13)

Schematic: whitherbone.sch

Parts:
ANT1, ANT2: RECE.20279.001E.01; U-FL3P-SMD-2.6X2.6X1.0MM
C1: TLJB227M006R0500; AVX-B
C2, C8, C26, C38, C84: 1uF 10V; C0402
C3, C7: 47uF DNP; C1206
C4, C5, C18, C29, C30, C32, C33, C35, C36, C70, C74, C75, C79, C82, C83: 10uF 25V; C0805
C6, C20, C25, C27, C28, C31, C34, C44, C53, C61, C62, C63, C64, C65, C66, C69, C71, C72, C73, C76, C77, C78, C80, C81: 100nF 25V; C0402
C9, C10: 10pF; C0402
C11: 1nF 1000V; C1206
C12, C13, C14, C15: 18pF 50V; C0402
C16, C24: 100uF 16V; C1210
C17, C19, C56, C68: 100nF 50V; C0805
C21, C22: 22uF 16V; C1206
C23: 75pF 50V; C0402
C37, C40: DNI; C0402
C39, C41, C42, C43, C45, C46, C47, C49, C50, C52, C54, C55, C57, C58, C59, C60: 33pF 50V; C0402
C48, C51: 47uF 25V; ELECTRO-SMD-C-6MM
C67: 220nF; C0402
D1, D5, D6, D7, D8: Red; LED-0603
D2, D3, D4: Green; LED-0603
D9, D10, D11, D12, D13: DF2S6.8FS; SOD-923
F1: MF-FSMF010X; F0603
FUD1, FUD2, FUD3, FUD4, FUD5, FUD6: FIDUCIAL; FIDUCIAL_40MIL
IC1, IC2: TPD4S012DRYR; SON6-0.5-1.45X1X0.55MM
J1: ST-USB-01H2; MICRO-USB5+5P-SMD-0.65-7.2X5.06MM
J2: DC-044; DCJ3P-11.6X9.6X7.0MM
J3: ST-TF-003J; MICRO-SD9+4P-SMD-16.1X14.5X1.85MM
J4: 6p-2.54 DNP; H6-2.54
J5: WY-1223; H4-2.54-10.2X5.6MM
J6: ST-HD-010; HDMI19P-0.5-15X12.15X6.18MM
J7, J8: 2510S-4P(T); H4-2.54
JP2: ST-USB-003A; USB4+2-2.0-90D
L1, L2, L7, L8, L9: BLM15PD121SN1D; L0402
L3: IHLP3232DZER100M01; INT2-7.268-8.64X8.18X4MM
L4, L5: BLM21PG331SN1D; L0805
L6: LQH44PN1R0NP0L; L4.4X3.0MM
L10: WPN201610MR47MT; L201610
MGT1, MGT2, MGT3, MGT4: MOUNTING_HOLE
Q1, Q2, Q3: BSS138W-7-F; SOT-323
Q4: MMBT2907A; SOT-323
R1, R2, R18, R51, R52, R53, R54: 1.5k 1%; R0402
R3, R21, R62, R69, R70: 10k 1%; R0402
R4, R6, R7, R8, R9, R10, R63, R67, R68, R71, R72, R73, R74, R75, R81, R82, R83, R84, R87, R88, R89, R90, R91, R92, R93, R94, R98, R100, R106, R108, R109, R112, R119: 10k; R0402
R5, R11, R12, R31, R79, R96: 1k; R0402
R13, R14, R15, R16, R19, R22, R25, R26, R27, R28, R29: 33R; R0402
R17: 499R; R0402
R20: 40.2k 1%; R0402
R23, R24, R47, R64, R65, R66, R85, R116, R117, R118: 0R; R0402
R30: DNP 10k; R0402
R32: 100K, 1%, DNI; R0402
R33, R34, R35, R36, R37, R38, R39, R40, R41, R42, R43, R44, R45, R46, R49, R50, R58, R60, R80, R113, R114: 100k 1%; R0402
R48, R97: 0R; R1206
R55: 1M 1%; R0402
R56: 1M, 1%, DNI; R0402
R57: 560k 1%; R0402
R59: 49.9R 1%; R0402
R61: 13.3k 1%; R0402
R76: 51k 1%; R0402
R77: 1.3k 1%; R0402
R78: 240k 1%; R0402
R86, R101: DNP; R0402
R95, R102, R103, R115: 22R; R0402
R99: 5.6K 1%; R0402
R104, R105: 2k; R0402
R107: 33k; R0402
R110, R111: 0.1R; R1206
SW1, SW2: SKRPABE010; BUTTON4P-SMD-4.5X3.2X2.5MM
TP1: PAD-TEST-POINT'4545'; TP_4545
TP2, TP3, TP4, TP9, TP11, TP12, TP13, TP14, TP15, TP16, TP21, TP22, TP23, TP24: TPB0,65; TP_B0,65
TP5, TP6, TP7, TP8, TP26: TESTPAD/W_HOLE_1X1
TP10, TP34: TEST-POINT-D65/35; TP-D65/35MIL
TP17, TP18, TP19, TP20, TP25, TP27, TP28, TP29, TP30, TP31, TP32: TEST-POINT'4545'; TP-D45MIL
U1: OSD3358-512M-BSM; BGA256-1.27-21X21MM
U2: SN74LVC1G07DCKR; 5P-SMD-2X1.2X1MM
U3: ATL431AIDBZR; SOT-23
U4: WL1835MODGBMOCT; MODULE100P-0.7-13.5X13.2MM
U5: APX811-44UG-7; SOT143-R
U6: TPS54302; SOT-23-6
U7: TPS2051BDGNR; MSOP8-0.65-3X3MM
U8, U16: TLV62569DBVT; SOT-23-5
U9: SN74LVC1G125DCKR; SOT-353
U10: SN74LVC2G241DCUR; DCU8
U11: IT66121FN; QFN64-0.5-9X9MM
U12: A4988SETTR-T; QFN-28-5MM
U13, U14: ESD-RCLAMP0524P; ESD10P-0.5-2.5X1X0.58MM
VR1: EVM3GSX50B14; ADJR3-SMD-3.6X3.3MM
X1: ST3215SB32768H5HPWAA; X2-SMD-3.2X1.5X0.55MM
Y1: CX3225GB24000P0HPQCC; CRYSTAL-TXC-7A

Connections:
1.8V-WIFI: C2.1, C7.2, C8.1, L1.2, R4.1, R6.1, R7.1, R8.1, R9.1, R10.1, R30.1, U4.38 (VIO)
3.3V-WIFI: C3.2, C4.1, C5.1, C6.1, L2.2, R5.2, R11.2, R12.2, U4.46 (VBAT_IN1), U4.47 (VBAT_IN2)
12VDC: C48.+, C51.+, C68.2, R97.2, U12.22 (VBB1), U12.28 (VBB2)
AGND: C25.2, C27.2, C28.2, R66.2, U1.A9 (AGND_ADC)
AIN7: U1.D6 (PMIC_MUX_OUT), U1.D7 (AIN7)
BAT_SENSE: TP6.P$1, U1.N7 (PMIC_BAT_SENSE)
BT_EN: Q3.1 (G), U1.H15 (MII1_TXD0), U4.41 (BT_EN)
BT_HCI_CTS: R14.2, U1.D13 (MDC)
BT_HCI_RTS: R13.2, U1.E13 (MDIO)
BT_HCI_RX: R16.2, U1.D15 (MII1_RXD2)
BT_HCI_TX: R15.2, U1.D14 (MII1_RXD3)
B_UART0_RX: J4.4, R80.2, U10.2 (1A)
B_UART0_TX: J4.5, U10.3 (2Y)
CEC: D12.1 (2), J6.13 (CE_REMOTE), R106.2, U11.17 (CEC)
CGND: C11.2, J1.P1 (GND), J1.P3 (GND), J1.P4 (GND), J1.P5 (GND), J1.P6 (GND), J3.G2, J3.G3, J3.G4 (G3), J6.PAD (SHELL1), J6.PAD1 (SHELL2), J6.PAD2 (SHELL3), J6.PAD3 (SHELL4), JP2.SG1 (GND), JP2.SG2 (GND), MGT1.P$1, MGT2.P$1, MGT3.P$1, MGT4.P$1, R48.2
CK_N: J6.12 (CK-), U11.21 (TXCM), U14.5, U14.6
CK_P: J6.10 (CK+), U11.22 (TXCP), U14.4, U14.7
CLKOUT2: C37.2, R79.2, R96.2, U4.36 (EXT_32K)
COILA+: J5.1, U12.21 (OUT1B)
COILA-: J5.2, U12.24 (OUT1A)
COILB+: J5.4, U12.1 (OUT2B)
COILB-: J5.3, U12.26 (OUT2A)
CUR_REF: U12.17 (REF), VR1.2 (3)
D0_N: J6.9 (D0-), U11.24 (TX0M), U14.2, U14.9
D0_P: J6.7 (D0+), U11.25 (TX0P), U14.1, U14.10
D1_N: J6.6 (D1-), U11.26 (TX1M), U13.5, U13.6
D1_P: J6.4 (D1+), U11.27 (TX1P), U13.4, U13.7
D2_N: J6.3 (D2-), U11.29 (TX2M), U13.2, U13.9
D2_P: J6.1 (D2+), U11.30 (TX2P), U13.1, U13.10
DDC_SCL: D9.1 (2), J6.15 (DDC_CLK), R102.2, R104.2
DDC_SDA: D10.1 (2), J6.16 (DDC_DATA), R103.2, R105.2
DIR(GPIO23): R88.1, U1.P5 (GPMC_AD9), U12.19 (DIR)
EEPROM_WP: TP10.P1, U1.M2 (EEPROM_WP), U1.N3 (GPMC_BEN0_CLE)
ENABLE(GPIO46): R94.1, U1.T6 (GPMC_AD14), U12.2 (ENABLE)
GND: ANT1.GND1, ANT1.GND2, ANT2.GND1, ANT2.GND2, C1.-, C2.2, C3.1, C4.2, C5.2, C6.2, C7.1, C8.2, C11.1, C16.1, C17.1, C18.1, C20.2, C21.1, C22.1, C24.2, C26.1, C29.1, C30.1, C31.2, C32.2, C33.1, C34.2, C35.1, C36.1, C37.1, C38.1, C39.2, C40.1, C41.2, C42.2, C43.2, C44.1, C45.2, C46.2, C47.2, C48.-, C49.2, C50.2, C51.-, C52.2, C53.2, C54.2, C55.2, C57.2, C58.2, C59.2, C60.2, C61.1, C62.1, C63.1, C64.1, C65.1, C66.1, C67.2, C69.1, C70.1, C71.1, C72.1, C73.1, C74.1, C75.1, C76.1, C77.1, C78.1, C79.1, C80.1, C81.1, C82.1, C83.1, C84.1, D9.2 (1), D10.2 (1), D11.2 (1), D12.2 (1), D13.2 (1), IC1.4 (GND), IC2.4 (GND), J1.5 (GND), J2.-, J2.CDN, J3.6 (VSS), J4.1, J6.2 (D2_SHIELD), J6.5 (D1_SHIELD), J6.8 (D0_SHIELD), J6.11 (CK_SHIELD), J6.17 (GND), J7.1, J7.4, J8.1, J8.4, JP2.4 (GND), Q1.2 (S), Q2.2 (S), Q3.2 (S), R3.2, R18.2, R32.1, R33.1, R35.1, R36.1, R37.1, R38.1, R39.1, R40.1, R41.1, R42.1, R43.1, R46.1, R48.1, R49.1, R50.1, R51.2, R52.2, R53.2, R54.2, R58.1, R61.1, R62.2, R64.1, R70.1, R77.1, R79.1, R80.1, R94.2, R98.2, R99.1, R101.1, R107.1, R108.2, R109.1, R110.1, R111.1, R114.1, R119.2, SW1.1, SW1.2, SW2.1, SW2.2, TP8.P$1, U1.D8 (DGND), U1.D9 (DGND), U1.E5 (DGND), U1.E6 (DGND), U1.E7 (DGND), U1.E8 (DGND), U1.E9 (DGND), U1.E10 (DGND), U1.E11 (DGND), U1.E12 (DGND), U1.F5 (DGND), U1.F12 (DGND), U1.G5 (DGND), U1.G12 (DGND), U1.H4 (DGND), U1.H5 (DGND), U1.H12 (DGND), U1.H13 (DGND), U1.J4 (DGND), U1.J5 (DGND), U1.J12 (DGND), U1.J13 (DGND), U1.K5 (DGND), U1.K12 (DGND), U1.L5 (DGND), U1.L12 (DGND), U1.M5 (DGND), U1.M6 (DGND), U1.M7 (DGND), U1.M8 (DGND), U1.M9 (DGND), U1.M10 (DGND), U1.M11 (DGND), U1.M12 (DGND), U1.N8 (DGND), U1.N9 (DGND), U2.3 (GND), U4.1 (GND1), U4.7 (GND2), U4.9 (GND3), U4.15 (GND4), U4.16 (GND5), U4.17 (GND6), U4.19 (GND7), U4.20 (GND8), U4.23 (GND9), U4.24 (GND10), U4.28 (GND11), U4.29 (GND12), U4.30 (GND13), U4.31 (GND14), U4.33 (GND15), U4.34 (GND16), U4.35 (GND17), U4.37 (GND18), U4.39 (GND19), U4.44 (GND20), U4.45 (GND21), U4.48 (GND22), U4.49 (GND23), U4.54 (GND24), U4.55 (GND25), U4.59 (GND26), U4.61 (GND27), U4.63 (GND28), U4.64 (GND29), U4.G1, U4.G2, U4.G3, U4.G4, U4.G5, U4.G6, U4.G7, U4.G8, U4.G9, U4.G10, U4.G11, U4.G12, U4.G13, U4.G14, U4.G15, U4.G16, U4.G17, U4.G18, U4.G19, U4.G20, U4.G21, U4.G22, U4.G23, U4.G24, U4.G25, U4.G26, U4.G27, U4.G28, U4.G29, U4.G30, U4.G31, U4.G32, U4.G33, U4.G34, U4.G35, U4.G36, U5.1 (GND), U6.1 (GND), U7.1 (GND), U7.9 (THERMAL), U8.2 (GND), U9.1 (!OE), U9.3 (GND), U10.1 (*1OE), U10.4 (GND), U11.41 (D18), U11.42 (D17), U11.43 (D16), U11.50 (D9), U11.52 (D8), U11.59 (D2), U11.60 (D1), U11.61 (D0), U11.65 (GND), U12.3 (GND), U12.18 (GND), U12.PAD (GND_PAD), U13.3, U13.8, U14.3, U14.8, U16.2 (GND), VR1.1
HDMI_1V2: C61.2, C62.2, C63.2, C64.2, C65.2, C66.2, C82.2, C83.2, L10.2, R113.2, TP18.T, U11.8 (IVDD12), U11.18 (PVCC12), U11.23 (AVCC12), U11.28 (DVDD12), U11.35 (IVDD12), U11.56 (IVDD12)
HDMI_3V3: C69.2, C71.2, C73.2, C76.2, C77.2, C78.2, L8.2, R81.1, R82.1, R83.1, R84.1, R100.1, R106.1, R109.2, TP19.T, U11.1 (OVDD), U11.9 (VCC33), U11.13 (OVDD33), U11.19 (PVCC33), U11.34 (OVDD), U16.1 (EN)
HDMI_5V: C84.2, D11.1 (2), F1.2, J6.18 (+5V), R104.1, R105.1, TP20.T
HDMI_AUDBCLK: U1.A1 (MCASP0_ACLKX), U11.7 (SCK/MCLK)
HDMI_AUDDOUT: R85.1, R86.1, U1.B1 (MCASP0_AHCLKR)
HDMI_AUDWCLK: U1.A2 (MCASP0_FSX), U11.6 (WS)
HDMI_INT: R83.2, U1.T15 (GPMC_A9), U11.10 (INT)
HDMI_NRST: C38.2, R84.2, U11.33 (SYSRSTN)
HPD: D13.1 (2), J6.19 (HPD), R107.2, U11.14 (HPD)
I2C0_SCL: R1.1, U1.C10 (I2C0_SCL), U1.D10 (PMIC_SCL)
I2C0_SDA: R2.1, U1.C11 (I2C0_SDA), U1.D11 (PMIC_SDA)
I2C2_SCL: R82.2, U1.A10 (UART1_RTSN), U11.12 (PCSCL)
I2C2_SDA: R81.2, U1.B10 (UART1_CTSN), U11.11 (PCSDA)
LCD_DATA0: C60.1, R50.2, U1.G3 (LCD_DATA0), U11.58 (D3)
LCD_DATA1: C59.1, R49.2, U1.G2 (LCD_DATA1), U11.57 (D4)
LCD_DATA2: C58.1, R46.2, U1.G1 (LCD_DATA2), U11.55 (D5)
LCD_DATA3: C57.1, R45.1, U1.H3 (LCD_DATA3), U11.54 (D6)
LCD_DATA4: C55.1, R44.1, U1.H2 (LCD_DATA4), U11.53 (D7)
LCD_DATA5: C46.1, R43.2, U1.H1 (LCD_DATA5), U11.49 (D10)
LCD_DATA6: C45.1, R42.2, U1.J3 (LCD_DATA6), U11.48 (D11)
LCD_DATA7: C43.1, R41.2, U1.J2 (LCD_DATA7), U11.47 (D12)
LCD_DATA8: C42.1, R40.2, U1.J1 (LCD_DATA8), U11.46 (D13)
LCD_DATA9: C41.1, R39.2, U1.K3 (LCD_DATA9), U11.45 (D14)
LCD_DATA10: C39.1, R38.2, U1.K2 (LCD_DATA10), U11.44 (D15)
LCD_DATA11: C54.1, R37.2, U1.K1 (LCD_DATA11), U11.40 (D19)
LCD_DATA12: C52.1, R36.2, U1.L3 (LCD_DATA12), U11.39 (D20)
LCD_DATA13: C50.1, R35.2, U1.L2 (LCD_DATA13), U11.38 (D21)
LCD_DATA14: C49.1, R34.1, U1.L1 (LCD_DATA14), U11.37 (D22)
LCD_DATA15: C47.1, R33.2, U1.M3 (LCD_DATA15), U11.36 (D23)
LCD_DE: R118.2, U11.62 (DE)
LCD_HSYNC: R117.2, U11.63 (HSYNC)
LCD_PCLK: R115.2, U11.51 (PCLK)
LCD_VSYNC: R116.2, U11.64 (VSYNC)
LDO_PGOOD: TP22.TP, U1.N4 (PMIC_LDO_PGOOD), U1.N5 (RTC_PWRONRSTN)
MMC0_CD: J3.9 (CDN), R75.1, U1.C14 (SPI0_CS1)
MMC0_CLK: C40.2, J3.5 (SCLK), R71.1, R95.1
MMC0_CMD: J3.3 (DI), R68.1, U1.B16 (MMC0_CMD)
MMC0_DAT0: J3.7 (DO), R72.1, U1.A16 (MMC0_DAT0)
MMC0_DAT1: J3.8 (DATA1), R73.1, U1.A15 (MMC0_DAT1)
MMC0_DAT2: J3.1 (DATA2), R67.1, U1.C16 (MMC0_DAT2)
MMC0_DAT3: J3.2 (CS), R74.1, U1.C15 (MMC0_DAT3)
MS1(GPIO27): R89.1, U1.T5 (GPMC_AD11), U12.9 (MS1)
MS2(GPIO44): R90.1, U1.P6 (GPMC_AD12), U12.10 (MS2)
MS3(GPIO45): R91.1, U1.R6 (GPMC_AD13), U12.11 (MS3)
MVCC: C53.1, L7.2, R87.2, R88.2, R89.2, R90.2, R91.2, R92.2, R93.2, R112.1, U12.15 (VDD)
unnamed: J1.1 (VCC), R47.1
unnamed: D5.-, R51.1
unnamed: R31.2, U5.2 (RESET#)
unnamed: TP9.TP, U1.F4 (VDDS_DDR)
unnamed: C81.2, F1.1, L9.2
unnamed: D4.-, R18.1
unnamed: R20.2, R21.1, U3.1 (R)
unnamed: Q4.1 (B), R17.1, U3.2 (K)
unnamed: D6.-, R52.1
unnamed: D7.-, R53.1
unnamed: D8.-, R54.1
unnamed: ANT2.D, C10.1
unnamed: ANT1.D, C9.1
unnamed: TP2.TP, U1.G4 (VDD_CORE)
unnamed: TP3.TP, U1.F13 (VDD_MPU)
unnamed: R96.1, U1.B4 (XDMA_EVENT_INTR1)
unnamed: TP4.TP, U1.G13 (VDDS_PLL)
unnamed: R95.2, U1.B15 (MMC0_CLK)
unnamed: C9.2, U4.32 (RF_ANT1)
unnamed: C10.2, U4.18 (RF_ANT2)
unnamed: TP29.T, U4.26 (GPIO2)
unnamed: R23.1, SW2.3, SW2.4
unnamed: TP31.T, U4.42 (WL_UART_DBG)
unnamed: TP32.T, U4.43 (BT_UART_DBG)
unnamed: R24.1, U2.4 (Y)
unnamed: TP17.T, U4.56 (BT_AUD_IN)
unnamed: R119.1, TP25.T, U4.57 (BT_AUD_OUT)
unnamed: R3.1, U1.M16 (RTC_KALDO_ENN)
unnamed: TP28.T, U4.60 (BT_AUD_CLK)
unnamed: TP30.T, U4.27 (GPIO1)
unnamed: D2.-, Q2.3 (D)
unnamed: R100.2, R101.2, U11.32 (PCADR)
unnamed: R98.1, U11.31 (ENTEST)
unnamed: R102.1, U11.16 (DDCSCL)
unnamed: R103.1, U11.15 (DDCSDA)
unnamed: R86.2, U11.2 (I2S3/SPDIF)
unnamed: R85.2, U11.5 (I2S0)
unnamed: TP27.T, U4.58 (BT_AUD_FSYNC)
unnamed: R99.2, U11.20 (REXT)
unnamed: R19.1, U4.6 (WL_SDIO_CMD)
unnamed: D1.+, R5.1
unnamed: D1.-, Q1.3 (D)
unnamed: R111.2, U12.27 (SENSE2)
unnamed: R110.2, U12.23 (SENSE1)
unnamed: C56.1, U12.4 (CP1)
unnamed: C56.2, U12.5 (CP2)
unnamed: R108.1, U12.13 (ROSC)
unnamed: C67.1, U12.8 (VREG)
unnamed: C68.1, U12.6 (VCP)
unnamed: D3.-, Q3.3 (D)
unnamed: D2.+, R11.1
unnamed: D3.+, R12.1
unnamed: R112.2, VR1.3 (2)
unnamed: J7.2, U9.4 (Y)
unnamed: R29.1, R30.2, U4.14 (WLAN_IRQ)
unnamed: R28.1, U4.13 (WL_SDIO_D3)
unnamed: R27.1, U4.12 (WL_SDIO_D2)
unnamed: R26.1, U4.11 (WL_SDIO_D1)
unnamed: R25.1, U4.10 (WL_SDIO_D0)
unnamed: R22.1, U4.8 (WL_SDIO_CLK)
unnamed: R115.1, U1.F1 (LCD_PCLK)
unnamed: R116.1, U1.F3 (LCD_VSYNC)
unnamed: L10.1, U16.3 (SW)
unnamed: R113.1, R114.2, U16.5 (FB)
unnamed: R76.2, R78.2, U8.5 (FB)
unnamed: L6.1, U8.3 (SW)
unnamed: R76.1, R77.2
unnamed: R117.1, U1.F2 (LCD_HSYNC)
unnamed: R57.1, R58.2, U6.5 (EN)
unnamed: R118.1, U1.E1 (LCD_AC_BIAS_EN)
unnamed: C19.2, U6.6 (BOOT)
unnamed: C19.1, L3.1, U6.2 (SW)
unnamed: C23.1, R59.1, R60.2
unnamed: C23.2, R60.1, R61.2, U6.4 (FB)
unnamed: R13.1, U4.50 (BT_HCI_RTS)
unnamed: R14.1, U4.51 (BT_HCI_CTS)
unnamed: R15.1, U4.52 (BT_HCI_TX)
unnamed: R16.1, U4.53 (BT_HCI_RX)
OSC0_GND: C12.2, C13.2, U1.N15 (OSC0_GND)
OSC0_IN: C12.1, R55.2, U1.P16 (OSC0_IN), Y1.P$2 (2)
OSC0_OUT: C13.1, R55.1, U1.N16 (OSC0_OUT), Y1.P$1 (1)
OSC1_GND: C14.2, C15.2, U1.B5 (OSC1_GND)
OSC1_IN: C14.1, R56.2, U1.A6 (OSC1_IN), X1.2
OSC1_OUT: C15.1, R56.1, U1.A5 (OSC1_OUT), X1.1
PMIC_INT: TP24.TP, U1.D4 (EXTINTN), U1.E4 (PMIC_NINT)
PMIC_MUX_IN: R69.1, R70.2, U1.N13 (PMIC_MUX_IN)
PMIC_NRESET: TP34.P1, U1.M13 (PMIC_NRESET)
PMIC_NWAKEUP: TP23.TP, U1.L4 (PMIC_NWAKEUP), U1.M4 (EXT_WAKEUP)
PMIC_PGOOD: U1.N12 (PMIC_PGOOD), U1.P11 (PWRONRSTN), U2.2 (A)
PWR_BUT: SW1.3, SW1.4, U1.T11 (PMIC_PB_IN)
PWR_EN: TP21.TP, U1.N10 (PMIC_POWER_EN), U1.N11 (PMIC_PWR_EN)
PWR_IN_12V: C16.2, C17.2, C18.2, J2.+, R57.2, R97.1, TP1.T, U6.3 (VIN)
RESET: R23.2, R24.2, U5.3 (MR#)
RESET(GPIO26): R93.1, U1.R5 (GPMC_AD10), U12.12 (RESET)
SLEEP(GPIO47): R92.1, U1.P7 (GPMC_AD15), U12.14 (SLEEP)
STEP(GPIO22): R87.1, U1.T4 (GPMC_AD8), U12.16 (STEP)
SYS_5V: C24.1, U7.2 (IN1), U7.3 (IN2)
SYS_ADC_1P8V: C28.1, R65.2, U1.A7 (SYS_ADC_1P8V)
SYS_RESETN: R31.1, R32.2, TP26.P$1, U1.R11 (WARMRSTN)
SYS_RTC_1P8V: Q4.3 (C), R20.1, TP14.TP, U1.K11 (SYS_RTC_1P8V), U1.L11 (SYS_RTC_1P8V), U2.5 (VCC), U3.3 (A)
SYS_VDD1_3P3V: C32.1, C34.1, C44.2, C70.2, C72.2, J3.4 (VDD), L8.1, R1.2, R2.2, R34.2, R44.2, R45.2, R63.1, R67.2, R68.2, R69.2, R71.2, R72.2, R73.2, R74.2, R75.2, TP12.TP, U1.F6 (SYS_VDD1_3P3V), U1.F7 (SYS_VDD1_3P3V), U1.G6 (SYS_VDD1_3P3V), U1.G7 (SYS_VDD1_3P3V), U5.4 (VCC), U8.1 (EN), U10.7 (2OE), U10.8 (VCC)
SYS_VDD2_3P3V: D4.+, TP13.TP, U1.F11 (SYS_VDD2_3P3V), U1.G11 (SYS_VDD2_3P3V)
SYS_VDD3_3P3V: Q4.2 (E), R17.2, R21.2, TP16.TP, U1.F8 (SYS_VDD3_3P3V), U1.F9 (VDDSHV4), U1.G8 (SYS_VDD3_3P3V), U1.H7 (SYS_VDD3_3P3V), U1.H8 (SYS_VDD3_3P3V), U1.H9 (VDDSHV6), U1.J7 (SYS_VDD3_3P3V), U1.J8 (SYS_VDD3_3P3V), U1.J9 (VDDSHV1), U1.K8 (SYS_VDD3_3P3V), U1.K9 (VDDSHV2), U1.L8 (SYS_VDD3_3P3V), U1.L9 (VDDSHV3)
SYS_VDD_1P8V: L1.1, TP15.TP, U1.F10 (SYS_VDD_1P8V), U1.G9 (VDDSHV5), U1.G10 (SYS_VDD_1P8V), U1.H10 (SYS_VDD_1P8V), U1.H11 (SYS_VDD_1P8V), U1.J10 (SYS_VDD_1P8V), U1.J11 (SYS_VDD_1P8V), U1.K10 (SYS_VDD_1P8V), U1.L10 (SYS_VDD_1P8V)
SYS_VOUT: C74.2, C75.2, C79.2, C80.2, L9.1, TP11.TP, U1.K6 (SYS_VOUT), U1.K7 (SYS_VOUT), U1.L6 (SYS_VOUT), U1.L7 (SYS_VOUT), U16.4 (VIN)
TEMP_SENSE: TP7.P$1, U1.N6 (PMIC_TS)
TO_NEOPIXEL: U1.B2 (MCASP0_AXR0), U9.2 (A)
UART0_RX: U1.A12 (UART0_RXD), U10.6 (1Y)
UART0_TX: U1.B12 (UART0_TXD), U10.5 (2A)
USB0_DM: IC1.1 (D+), J1.2 (DM), U1.K16 (USB0_DM)
USB0_DP: IC1.2 (D-), J1.3 (DP), U1.K15 (USB0_DP)
USB0_ID: IC1.3 (ID), J1.4 (ID), U1.K14 (USB0_ID)
USB1_DM: IC2.1 (D+), JP2.2 (D-), U1.L16 (USB1_DM)
USB1_DP: IC2.2 (D-), JP2.3 (D+), U1.L15 (USB1_DP)
USB1_DRVVBUS: R62.1, U1.M14 (USB1_DRVVBUS), U7.4 (EN#)
USB1_ID: R64.2, U1.L14 (USB1_ID)
USB1_OC#: R63.2, U7.5 (OC#)
USB1_VBUS: L4.2, U1.M15 (USB1_VBUS)
USR0: D5.+, U1.P13 (GPMC_A5)
USR1: D6.+, U1.T14 (GPMC_A6)
USR2: D7.+, U1.R14 (GPMC_A7)
USR3: D8.+, U1.P14 (GPMC_A8)
VBUS.HOST: JP2.1 (VBUS), L5.2
VBUS.OUT: C31.1, IC2.6 (VBUS), L4.1, L5.1, U7.6 (OUT1), U7.7 (OUT2), U7.8 (OUT3)
VDD_3V3B: C35.2, C36.2, L2.1, L6.2, L7.1, R78.1
VDD_5V: C1.+, C21.2, C22.2, C26.2, C29.2, C30.2, C33.2, J7.3, J8.2, J8.3, L3.2, R59.2, U1.P10 (VIN_AC), U1.R10 (VIN_AC), U1.T10 (VIN_AC), U8.4 (VIN), U9.5 (VCC)
VDD_BAT: TP5.P$1, U1.P8 (VIN_BAT), U1.R8 (VIN_BAT), U1.T8 (VIN_BAT)
VDD_USB_5V: C20.1, IC1.6 (VBUS), R47.2, U1.J16 (USB0_VBUS), U1.P9 (VIN_USB), U1.R9 (VIN_USB), U1.T9 (VIN_USB)
VREFN: R66.1, U1.B9 (VREFN)
VREFP: C25.1, C27.1, R65.1, U1.B7 (VREFP)
WIFI_LED(GPIO3_01): Q1.1 (G), U1.F14 (MII1_CRS)
WL_EN: Q2.1 (G), U1.H16 (MII1_TX_CLK), U4.40 (WLAN_EN)
WL_IRQ: R29.2, U1.H14 (MII1_TXD1)
WL_SDIO_CLK: R9.2, R22.2, U1.D16 (MII1_RXD1)
WL_SDIO_CMD: R10.2, R19.2, U1.G14 (MII1_TX_EN)
WL_SDIO_D0: R4.2, R25.2, U1.F16 (MII1_RX_DV)
WL_SDIO_D1: R6.2, R26.2, U1.G15 (MII1_TXD3)
WL_SDIO_D2: R7.2, R27.2, U1.G16 (MII1_TXD2)
WL_SDIO_D3: R8.2, R28.2, U1.F15 (MII1_COL)

Notes on the sheet:
Power & Reset
Clocks, Analog & USB
SiP Interfaces
Boot configuration
HDMI
Micro SD card slot
User LEDs
USB Client
SiP GND & Misc
1/12
3/12
2/12
4/12
5/12
9/12
Mounting Holes
Fiducials
12/12
PCADR pull high: 0x9A PCADR pull low : 0x98
Differential impedance: 100 Ohm
Red
Green
Blue
ESD Protection Diodes close to HDMI Connector.
WiFi Module
USB Host
Neopixel Connector
FAN Connector
These signals are all 1.8V
Vout=0.6Vx(1+R1/R2)
I = 3A
I = 2A
I = 1A
I = 200mA
I = 100mA
I = 500mA

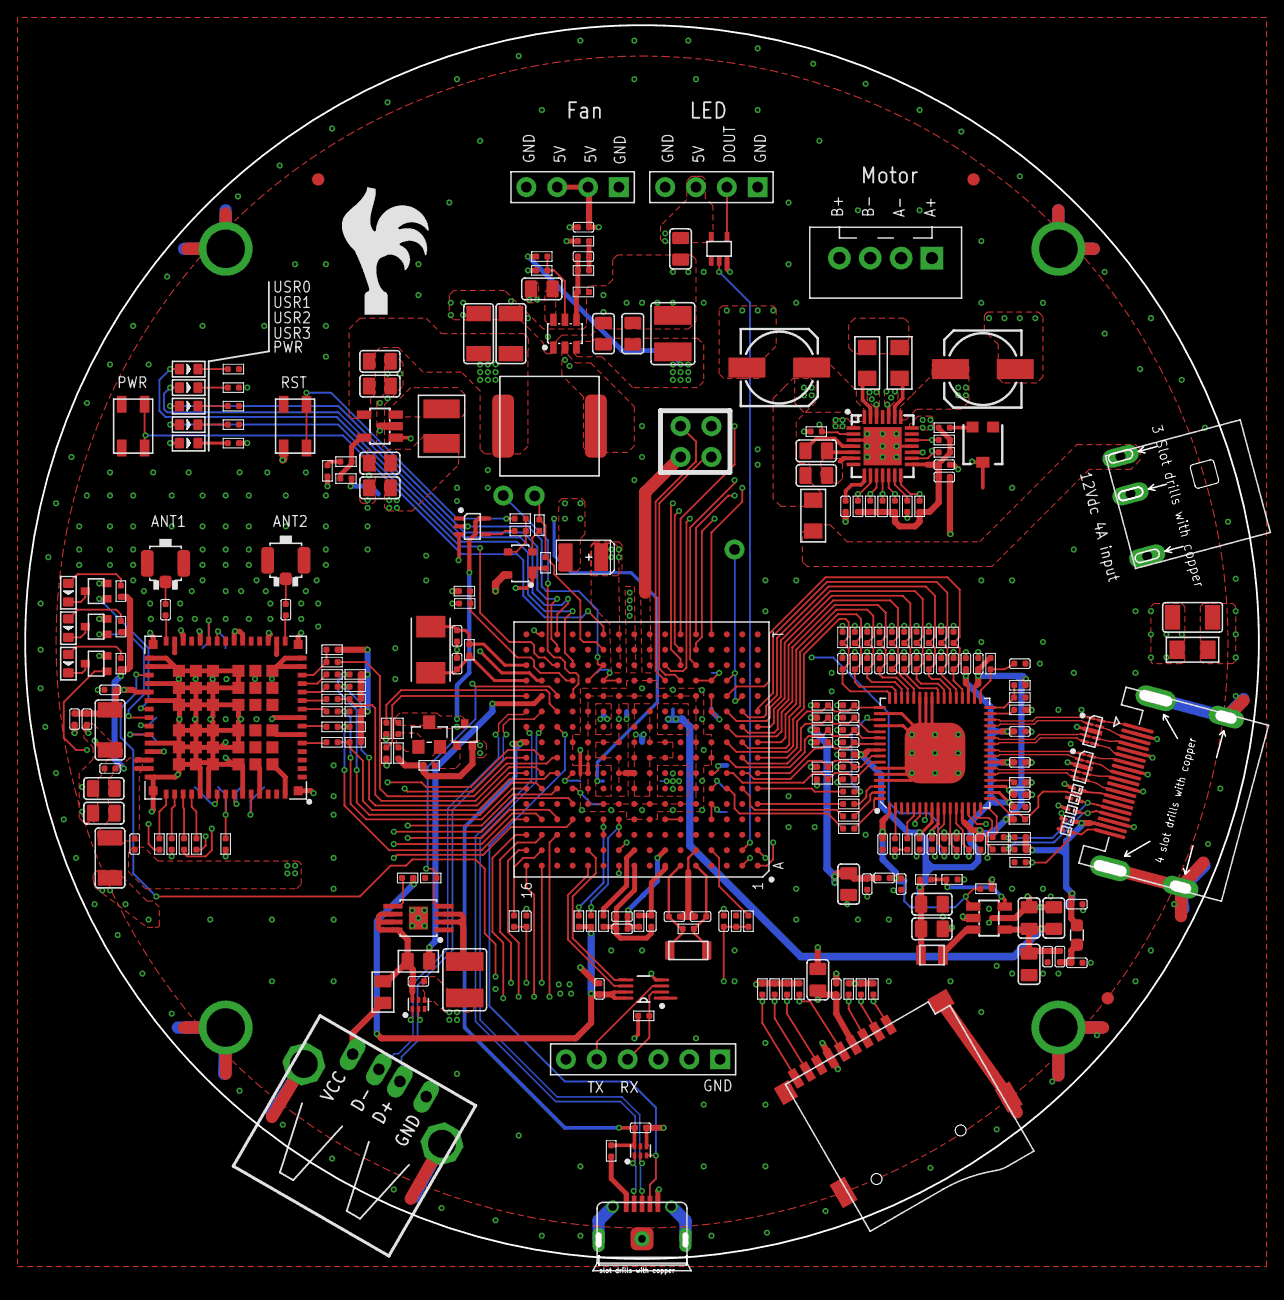
[picture p14: board whitherbone.brd from above]

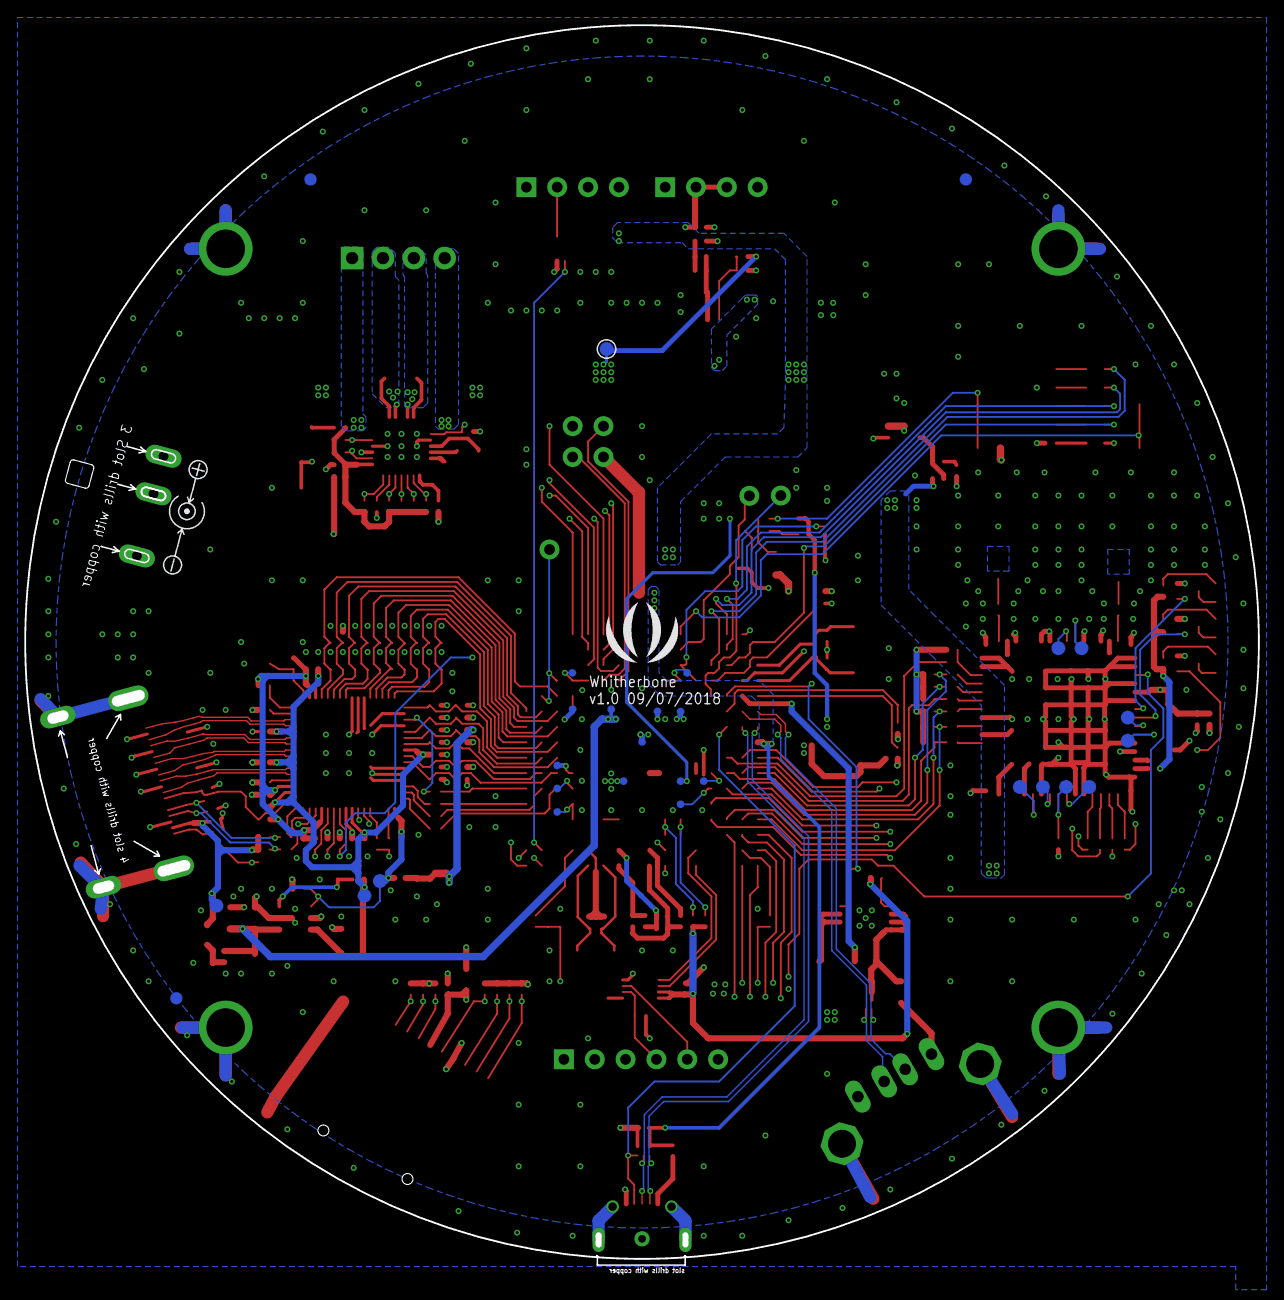
[picture p15: board whitherbone.brd from below]

Board: 4 copper layers, 101.6 x 102.1 mm, 308 parts (30 on the bottom side), 219 nets.

Other parts of the board:
U$1: SEEED-SILK-TNAME-280*268MIL
