jadonk/whitherbone/(commit log)

2017-12-11 Clone PocketBeagle A2a design
    [PocketBeagle-B.Paste.gbr, PocketBeagle-B.SilkS.gbr, PocketBeagle-Bottom.gbr, PocketBeagle-DigitalGND.gbr, PocketBeagle-Edge.Cuts.gbr, PocketBeagle-F.Paste.gbr, PocketBeagle-F.SilkS.gbr, PocketBeagle-NPTH.drl]
2017-12-11 Hack in TFP410
    [witherbone.sch]
2017-12-11 Make sure name is whitherbone everywhere
    [whitherbone.kicad_pcb, whitherbone.sch]
2018-01-04 SCH: label boot configuration
    [whitherbone.sch]
2018-07-13 Start EAGLE version based on BeagleBone Black Wireless
    [whitherbone.brd, whitherbone.sch]
2018-07-14 Hooked up some stuff
    [whitherbone.sch]
2018-07-14 Connected WiFi/BT
    [whitherbone.brd, whitherbone.sch]
2018-07-15 Add HDMI
    [whitherbone.brd, whitherbone.sch]
2018-07-16 USR LED connections
    [whitherbone.brd, whitherbone.sch]
2018-07-17 Power and other clean-up
    [whitherbone.brd, whitherbone.sch]
2018-07-17 Stopping for the night
    [whitherbone.brd, whitherbone.sch]
2018-07-17 Started motor driver
    [whitherbone.brd, whitherbone.sch]
2018-07-17 Some minor power fixups
    [whitherbone.brd, whitherbone.sch]
2018-07-17 Move WiFi signals to 1.8V and remove level shifters
    [whitherbone.brd, whitherbone.sch]
2018-07-17 Copied BigEasyDriver
    [whitherbone.brd, whitherbone.sch]
2018-07-17 Wired up BigEasyDriver
    [whitherbone.brd, whitherbone.sch]
2018-07-17 Add connector for Neopixels (not yet connected)
    [whitherbone.brd, whitherbone.sch]
2018-07-18 Connected NEOPIXEL connector
    [whitherbone.brd, whitherbone.sch]
2018-07-18 Add quick decoupling cap for neopixel output
    [whitherbone.brd, whitherbone.sch]
2018-07-18 Add quick fan connector
    [whitherbone.brd, whitherbone.sch]
2018-07-18 Add a quick schematic PDF
2018-08-23 Use version from Seeed
    [whitherbone.brd, whitherbone.sch]
2018-09-12 Remove KiCAD version
    [whitherbone.kicad_pcb, whitherbone.sch]
2018-09-12 Update to latest from Seeed
    * Layout complete
    * Added mechanical drawing (DXF) for board
    [whitherbone.brd, whitherbone.dxf, whitherbone.sch]
2018-09-12 Update LICENSE
    Removed any utilization of Michael Welling's work. No reason, it just wasn't used in this EAGLE version from Seeed and we dropped the KiCAD version for now. I left in Aron, because we might have some symbols in EAGLE from his work. I'm relying on Seeed to provide updates on any licensed components they used.
2018-11-13 Latest from Seeed
    [whitherbone.brd, whitherbone.sch]
