jadonk/whitherbone/(notices)

Notices in the files:
EAGLE/whitherbone.sch:
licensed under a Creative Commons
